Lucasmnascimento94/CS-341/ATMEGA-SCHEMATICS/SNAKE_GAME/SNAKE_GAME_PROGRAMMER_HARDWARE.drawio.pdf

Analog Switch
(CD4066BEU)

USB-UART
CONVERTER

USB_PORT

ATmega8
ISP

Analog Switch
(CD4066BEU)

FLOW_CONTROL

ATmega168
GRID_CONTROLLER

ATmega168
GAME_CONTROLLER

RESET_GRID_CONTROLLER

### SCK_BUS

MISO_BUS
MOSI_BUS

RESET_GAME_CONTROLLER

EXTERNAL FLASH

CHIP SELECT (CS)

External Programmer
Access

MISO_EXT

MOSI_EXT
SCK_EXT

RESET_PROGRAMMER

FLOW CONTROL
SWITCH (B)

LEVEL_SHIFTER

RXD_ISP

TXD_ISP
RTS_ISP

CTS_ISP

Analog Switch
(CD4066BEU)

RXD_ESP
TXD_ESP
CTS_ESP

FLOW CONTROL
SWITCH (B)

Analog Switch
(CD4066BEU)

RTS_ESP

RXD
TXD
RTS
CTS

FLOW_CONTROL

ESP

RXD
TXD

RTS
CTS

## PROGRAMMING LOGIC FLOW
