Lucasmnascimento94/CS-341/ATMEGA-SCHEMATICS/SNAKE_GAME/Clock_analyzes.xlsx

Sheet: Sheet1
Snake Game Clock Analyses
Atmega Clock Parameters |  |  | ws2812b Clock Parameters
Frequency |  | dcy (duty cycle) | Protocol Demand |  |  |  |  |  |  | GAME FPS
MHz | Hz |  | Data Feed |  |  |  |  |  |  | MIN_FPS
16 | 16000000 | 6.25e-08 | Kb/s | b/s | B/s | bit_cycle(us) | bi_cycle(s) | Latch(us) | Latch(s) | -
20 | 20000000 | 5e-08 | 800 | 800000 | 100000 | 1.25 | 1.25e-06 | 50 | 5e-05 | 14
Analyses
Row_Size | Column_Size | Pixel_Count | bit_per_grid | grid_cycle (CPU Time consumption) |  |  | max_FPS | fps_check
- | - | - | - | s | ms | us | -
16 | 8 | 128 | 3072 | 0.00389 | 3.89 | 3890 | 257.0694087 | OK
16 | 16 | 256 | 6144 | 0.00773 | 7.73 | 7730 | 129.3661061 | OK
24 | 16 | 384 | 9216 | 0.01157 | 11.57 | 11570 | 86.43042351 | OK
24 | 24 | 576 | 13824 | 0.01733 | 17.33 | 17330 | 57.7034045 | OK
32 | 24 | 768 | 18432 | 0.02309 | 23.09 | 23090 | 43.30879168 | OK
32 | 32 | 1024 | 24576 | 0.03077 | 30.77 | 30770 | 32.49918752 | OK
48 | 32 | 1536 | 36864 | 0.04613 | 46.13 | 46130 | 21.6778669 | OK
48 | 48 | 2304 | 55296 | 0.06917 | 69.17 | 69170 | 14.4571346 | OK
64 | 48 | 3072 | 73728 | 0.09221 | 92.21 | 92210 | 10.84481076 | FAIL
64 | 64 | 4096 | 98304 | 0.12293 | 122.93 | 122930 | 8.134710811 | FAIL
Project | Snake Game
Board | UMB-CS341-SNK-168-4848-F25-V1
Owner | Lucas Nascimento | Umass Boston - Computer Science
Rev | 1
Student_1 | -
Student_2 | -
Student_3 | -
Checked by: | Beatriz M Perez
Notes: | -

Sheet: BOM
Reference | Qty | Value | DNP | Exclude from BOM | Exclude from Board | Footprint | Datasheet
220UF1 | 1 | C_Polarized |  |  |  | Capacitor_THT:C_Disc_D3.0mm_W1.6mm_P2.50mm | ~
C1,C2,C3,C4,C5 | 5 | C_Small |  |  |  | Capacitor_THT:CP_Radial_D5.0mm_P2.50mm | ~
D1 | 1 | LED |  |  |  | LED_THT:LED_D1.8mm_W3.3mm_H2.4mm | ~
H1,H2,H3,H4,H5,H6,H7 | 7 | MountingHole |  | Excluded from BOM |  | MountingHole:MountingHole_3.2mm_M3 | ~
J1 | 1 | GRID |  |  |  | TerminalBlock:TerminalBlock_MaiXu_MX126-5.0-03P_1x03_P5.00mm | ~
J4 | 1 | USB_ASP |  |  |  | Connector_IDC:IDC-Header_2x05_P2.54mm_Vertical | ~
J5 | 1 | BUTTONS |  |  |  | TerminalBlock:TerminalBlock_MaiXu_MX126-5.0-03P_1x03_P5.00mm | ~
J6 | 1 | JOYSTICK |  |  |  | TerminalBlock:TerminalBlock_MaiXu_MX126-5.0-04P_1x04_P5.00mm | ~
J7 | 1 | UART_TERM |  |  |  | Connector_PinSocket_2.54mm:PinSocket_1x04_P2.54mm_Vertical | ~
J8 | 1 | PCF_SCREEN |  |  |  | TerminalBlock:TerminalBlock_MaiXu_MX126-5.0-04P_1x04_P5.00mm | ~
J9 | 1 | GROUND |  |  |  | TerminalBlock:TerminalBlock_MaiXu_MX126-5.0-04P_1x04_P5.00mm | ~
J10 | 1 | VCC |  |  |  | TerminalBlock:TerminalBlock_MaiXu_MX126-5.0-04P_1x04_P5.00mm | ~
J11 | 1 | PJ-102A |  |  |  | Connector_BarrelJack:BarrelJack_Horizontal | https://www.cui.com/product/resource/digikeypdf/pj-102a.pdf
R1,R2,R3,R4,R5,R6,R7,R13 | 8 | 100 |  |  |  | Resistor_THT:R_Axial_DIN0207_L6.3mm_D2.5mm_P10.16mm_Horizontal | ~
R14,R15,R16,R17,R18,R19,R20,R21,R22,R23,R24 | 11 | 4.7k |  |  |  | Resistor_THT:R_Axial_DIN0207_L6.3mm_D2.5mm_P10.16mm_Horizontal | ~
SW1 | 1 | SW_Push |  |  |  | Button_Switch_THT:SW_PUSH_6mm | ~
U1 | 1 | ATmega168A-P |  |  |  | Package_DIP:DIP-28_W7.62mm | http://ww1.microchip.com/downloads/en/DeviceDoc/ATmega48A_88A_168A-Data-Sheet-40002007A.pdf
Y1 | 1 | Crystal |  |  |  | Crystal:Resonator-2Pin_W6.0mm_H3.0mm | ~
