Lucasmnascimento94/CS-341/ATMEGA-SCHEMATICS/SNAKE_GAME/Clock_analyzes.ods

Sheet: Analyses
Snake Game Clock Analyses
Atmega Clock Parameters |  |  | ws2812b Clock Parameters
Frequency |  | dcy (duty cycle) | Protocol Demand |  |  |  |  |  |  | GAME FPS
MHz | Hz |  | Data Feed |  |  |  |  |  |  | MIN_FPS
16 | 16000000 | 0.0000000625 | Kb/s | b/s | B/s | bit_cycle(us) | bi_cycle(s) | Latch(us) | Latch(s) | -
20 | 20000000 | 0.00000005 | 800 | 800000 | 100000 | 1.25 | 0.00000125 | 50 | 0.00005 | 14
Analyses |  |  |  |  |  |  |  |  |  |  | 1228.8
Row_Size | Column_Size | Pixel_Count | bit_per_grid | grid_cycle (CPU Time consumption) |  |  | max_FPS | fps_check
- | - | - | - | s | ms | us | -
16 | 8 | 128 | 3072 | 0.00389 | 3.89 | 3890 | 257.06940874036 | OK
16 | 16 | 256 | 6144 | 0.00773 | 7.73 | 7730 | 129.366106080207 | OK
24 | 16 | 384 | 9216 | 0.01157 | 11.57 | 11570 | 86.4304235090752 | OK
24 | 24 | 576 | 13824 | 0.01733 | 17.33 | 17330 | 57.7034045008655 | OK
32 | 24 | 768 | 18432 | 0.02309 | 23.09 | 23090 | 43.308791684712 | OK
32 | 32 | 1024 | 24576 | 0.03077 | 30.77 | 30770 | 32.499187520312 | OK
48 | 32 | 1536 | 36864 | 0.04613 | 46.13 | 46130 | 21.6778668978972 | OK |  |  | 0.0000000625
48 | 48 | 2304 | 55296 | 0.06917 | 69.17 | 69170 | 14.4571345959231 | OK
64 | 48 | 3072 | 73728 | 0.09221 | 92.21 | 92210 | 10.8448107580523 | FAIL
64 | 64 | 4096 | 98304 | 0.12293 | 122.93 | 122930 | 8.13471081103067 | FAIL
Atmega Memory Parameters |  |  |  | Game Params
Flash |  | Ram |  | Grid_x | Grid_y | #Cells | Cell Size | Total Ram | Snake_Limit | Memory_Check
kbytes | bytes | kbytes | bytes | - |  |  | bytes | bytes
16 | 16000 | 2 | 2000 | 48 | 32 | 1536 | 9 | 13824 | 111.111111111111
 |  |  |  | 40 | 32 | 1280 |  | 11520
 |  |  |  | 32 | 32 | 1024 |  | 9216
 |  |  |  | 24 | 32 | 768 |  | 6912
 |  |  |  |  |  |  | 13824
Project | Snake Game
Board | UMB-CS341-SNK-168-4848-F25-V1
Owner | Lucas Nascimento | Umass Boston - Computer Science
Rev | 1
Student_1 | -
Student_2 | -
Student_3 | -
Checked by: | Beatriz M Perez
Notes: | -
 |  |  |  |  |  |  |  |  |  |  |  | _builtin_avr_delay_cycles(c)
 |  |  |  |  |  |  |  |  |  |  |  |  |  |  |  | 256
 |  |  |  |  |  |  |  |  |  |  |  |  | G | G | G | G | G | G | G | G | R | R | R | R | R | R | R | R | B | B | B | B | B | B | B | B
 |  |  |  |  |  |  |  |  |  |  |  |  | 1 | 2 | 3 | 4 | 5 | 6 | 7 | 8 | 9 | 10 | 11 | 12 | 13 | 14 | 15 | 16 | 17 | 18 | 19 | 20 | 21 | 22 | 23 | 24
 |  |  |  |  |  |  |  |  |  |  |  |  | 0 | 0 | 0 | 0 | 0 | 0 | 0 | 0 | 1 | 1 | 1 | 1 | 1 | 1 | 1 | 1 | 0 | 0 | 0 | 0 | 0 | 0 | 0 | 0

Sheet: GRID
 | EVEN LINE PATTERN – FULL ADDRESS EQUATION |  |  |  |  |  |  |  |  | ODD LINE PATTERN – FULL ADDRESS EQUATION
 | Address: |  | (J-1)*8 + I + (K-1)*256 |  |  |  |  |  |  | Address: |  | (J*8) + (1- I) + (K-1)*256
 | I: |  | I’ – (k-1)*8 |  |  |  |  |  |  | I: |  | I’ – (k-1)*8
ORIGINAL PIXEL ADDRESS TABLE |  |  | 48 | 47 | 46 | 45 | 44 | 43 | 42 | 41 | 40 | 39 | 38 | 37 | 36 | 35 | 34 | 33 | 32 | 31 | 30 | 29 | 28 | 27 | 26 | 25 | 24 | 23 | 22 | 21 | 20 | 19 | 18 | 17 | 16 | 15 | 14 | 13 | 12 | 11 | 10 | 9 | 8 | 7 | 6 | 5 | 4 | 3 | 2 | 1
 |  | 32 | 1288 | 1287 | 1286 | 1285 | 1284 | 1283 | 1282 | 1281 | 1280 | 1279 | 1278 | 1277 | 1276 | 1275 | 1274 | 1273 | 776 | 775 | 774 | 773 | 772 | 771 | 770 | 769 | 768 | 767 | 766 | 765 | 764 | 763 | 762 | 761 | 264 | 263 | 262 | 261 | 260 | 259 | 258 | 257 | 256 | 255 | 254 | 253 | 252 | 251 | 250 | 249 | 32 | 256 | 255 | 254 | 253 | 252 | 251 | 250
 |  | 31 | 1289 | 1290 | 1291 | 1292 | 1293 | 1294 | 1295 | 1296 | 1265 | 1266 | 1267 | 1268 | 1269 | 1270 | 1271 | 1272 | 777 | 778 | 779 | 780 | 781 | 782 | 783 | 784 | 753 | 754 | 755 | 756 | 757 | 758 | 759 | 760 | 265 | 266 | 267 | 268 | 269 | 270 | 271 | 272 | 241 | 242 | 243 | 244 | 245 | 246 | 247 | 248 | 31 | 241 | 242 | 243 | 244 | 245 | 246 | 247
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
 |  |  |  |  |  |  |  |  |  |  |  |  |  |  |  |  |  |  |  |  |  |  |  |  |  |  |  |  |  |  | 63
 |  |  |  |  |  |  |  |  |  |  |  |  |  |  |  |  |  |  |  |  |  |  |  |  |  |  |  |  | 0.000063

Sheet: BOM
Reference | Qty | Value | DNP | Exclude from BOM | Exclude from Board | Footprint | Datasheet
220UF1 | 1 | C_Polarized |  |  |  | Capacitor_THT:C_Disc_D3.0mm_W1.6mm_P2.50mm | ~
C1,C2,C3,C4,C5 | 5 | C_Small |  |  |  | Capacitor_THT:CP_Radial_D5.0mm_P2.50mm | ~
D1 | 1 | LED |  |  |  | LED_THT:LED_D1.8mm_W3.3mm_H2.4mm | ~
H1,H2,H3,H4,H5,H6,H7 | 7 | MountingHole |  | Excluded from BOM |  | MountingHole:MountingHole_3.2mm_M3 | ~
J1 | 1 | GRID |  |  |  | TerminalBlock:TerminalBlock_MaiXu_MX126-5.0-03P_1x03_P5.00mm | ~
J4 | 1 | USB_ASP |  |  |  | Connector_IDC:IDC-Header_2x05_P2.54mm_Vertical | ~
J5 | 1 | BUTTONS |  |  |  | TerminalBlock:TerminalBlock_MaiXu_MX126-5.0-03P_1x03_P5.00mm | ~
J6 | 1 | JOYSTICK |  |  |  | TerminalBlock:TerminalBlock_MaiXu_MX126-5.0-04P_1x04_P5.00mm | ~
J7 | 1 | UART_TERM |  |  |  | Connector_PinSocket_2.54mm:PinSocket_1x04_P2.54mm_Vertical | ~
J8 | 1 | PCF_SCREEN |  |  |  | TerminalBlock:TerminalBlock_MaiXu_MX126-5.0-04P_1x04_P5.00mm | ~
J9 | 1 | GROUND |  |  |  | TerminalBlock:TerminalBlock_MaiXu_MX126-5.0-04P_1x04_P5.00mm | ~
J10 | 1 | VCC |  |  |  | TerminalBlock:TerminalBlock_MaiXu_MX126-5.0-04P_1x04_P5.00mm | ~
J11 | 1 | PJ-102A |  |  |  | Connector_BarrelJack:BarrelJack_Horizontal | https://www.cui.com/product/resource/digikeypdf/pj-102a.pdf
R1,R2,R3,R4,R5,R6,R7,R13 | 8 | 100 |  |  |  | Resistor_THT:R_Axial_DIN0207_L6.3mm_D2.5mm_P10.16mm_Horizontal | ~
R14,R15,R16,R17,R18,R19,R20,R21,R22,R23,R24 | 11 | 4.7k |  |  |  | Resistor_THT:R_Axial_DIN0207_L6.3mm_D2.5mm_P10.16mm_Horizontal | ~
SW1 | 1 | SW_Push |  |  |  | Button_Switch_THT:SW_PUSH_6mm | ~
U1 | 1 | ATmega168A-P |  |  |  | Package_DIP:DIP-28_W7.62mm | http://ww1.microchip.com/downloads/en/DeviceDoc/ATmega48A_88A_168A-Data-Sheet-40002007A.pdf
Y1 | 1 | Crystal |  |  |  | Crystal:Resonator-2Pin_W6.0mm_H3.0mm | ~
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
