Lucasmnascimento94/CS-341/ATMEGA-SCHEMATICS/SNAKE_GAME/isp_tests/isp_decoder/blinky.csv

Time [s] | Packet ID | MOSI | MISO
6.8434262500 | 0 | 0xAC | 0xE9
6.8444904000 | 0 | 0x53 | 0x72
6.8456048500 | 0 | 0x00 | 0x53
6.8466717000 | 0 | 0x00 | 0x00
6.8583836500 | 0 | 0x30 | 0x00
6.8594399000 | 0 | 0x00 | 0x30
6.8605444000 | 0 | 0x00 | 0x00
6.8616072500 | 0 | 0x00 | 0x1E
6.8633885000 | 0 | 0x30 | 0x00
6.8644372500 | 0 | 0x00 | 0x30
6.8654988500 | 0 | 0x01 | 0x00
6.8665444500 | 0 | 0x00 | 0x94
6.8682129000 | 0 | 0x30 | 0x00
6.8692429000 | 0 | 0x00 | 0x30
6.8703470000 | 0 | 0x02 | 0x00
6.8713763500 | 0 | 0x00 | 0x06
6.8736581000 | 0 | 0xAC | 0x00
6.8747365500 | 0 | 0x80 | 0xAC
6.8757977000 | 0 | 0x00 | 0x80
6.8768643000 | 0 | 0x00 | 0x00
6.9899111500 | 0 | 0xAC | 0xB6
6.9909932500 | 0 | 0x53 | 0x8C
6.9921131000 | 0 | 0x00 | 0x53
6.9931586500 | 0 | 0x00 | 0x00
6.9964043500 | 0 | 0x20 | 0x00
6.9974839500 | 0 | 0x00 | 0x20
6.9985242000 | 0 | 0x40 | 0x00
6.9996070000 | 0 | 0x00 | 0xFF
7.0006941000 | 0 | 0x28 | 0x00
7.0018040000 | 0 | 0x00 | 0x28
7.0028710000 | 0 | 0x40 | 0x00
7.0039271000 | 0 | 0x00 | 0xFF
7.0050087000 | 0 | 0x20 | 0x00
7.0061000500 | 0 | 0x00 | 0x20
7.0071697000 | 0 | 0x41 | 0x00
7.0082363000 | 0 | 0x00 | 0xFF
7.0093585000 | 0 | 0x28 | 0x00
7.0104333500 | 0 | 0x00 | 0x28
7.0115377500 | 0 | 0x41 | 0x00
7.0126098500 | 0 | 0x00 | 0xFF
7.0136913500 | 0 | 0x20 | 0x00
7.0147960500 | 0 | 0x00 | 0x20
7.0158736500 | 0 | 0x42 | 0x00
7.0169734000 | 0 | 0x00 | 0xFF
7.0180570000 | 0 | 0x28 | 0x00
7.0191669000 | 0 | 0x00 | 0x28
7.0201992500 | 0 | 0x42 | 0x00
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
10.4090582000 | 0 | 0x7C | 0x00
10.4101197500 | 0 | 0x00 | 0xFF
10.4112150000 | 0 | 0x28 | 0x00
10.4123061500 | 0 | 0x00 | 0x28
10.4133679500 | 0 | 0x7C | 0x00
10.4144292000 | 0 | 0x00 | 0xFF
10.4155163000 | 0 | 0x20 | 0x00
10.4166376500 | 0 | 0x00 | 0x20
10.4176612000 | 0 | 0x7D | 0x00
10.4186905000 | 0 | 0x00 | 0xFF
10.4197298500 | 0 | 0x28 | 0x00
10.4207996000 | 0 | 0x00 | 0x28
10.4218317500 | 0 | 0x7D | 0x00
10.4229227500 | 0 | 0x00 | 0xFF
10.4239643000 | 0 | 0x20 | 0x00
10.4249941500 | 0 | 0x00 | 0x20
10.4260187000 | 0 | 0x7E | 0x00
10.4270425500 | 0 | 0x00 | 0xFF
10.4280925500 | 0 | 0x28 | 0x00
10.4291435000 | 0 | 0x00 | 0x28
10.4302478500 | 0 | 0x7E | 0x00
10.4312772500 | 0 | 0x00 | 0xFF
10.4323433000 | 0 | 0x20 | 0x00
10.4334103500 | 0 | 0x00 | 0x20
10.4344559500 | 0 | 0x7F | 0x00
10.4355015500 | 0 | 0x00 | 0xFF
10.4365779000 | 0 | 0x28 | 0x00
10.4376290000 | 0 | 0x00 | 0x28
10.4386905000 | 0 | 0x7F | 0x00
10.4397522500 | 0 | 0x00 | 0xFF
