Lucasmnascimento94/CS-341/ATMEGA-SCHEMATICS/SNAKE_GAME/isp_tests/isp_decoder/powertest_5vsupply.csv

Time [s] | Packet ID | MOSI | MISO
1.0328180000 | 0 | 0xAC | 0x00
1.0329436400 | 0 | 0x53 | 0x00
1.0330693200 | 0 | 0x00 | 0x53
1.0331952400 | 0 | 0x00 | 0x00
1.0333222800 | 0 | 0xAC | 0x00
1.0334481600 | 0 | 0x80 | 0xAC
1.0335740400 | 0 | 0x00 | 0x80
1.0336998000 | 0 | 0x00 | 0x00
1.1400418000 | 1 | 0xAC | 0x00
1.1401674000 | 1 | 0x53 | 0x00
1.1402930400 | 1 | 0x00 | 0x53
1.1404189600 | 1 | 0x00 | 0x00
1.1405474800 | 1 | 0x40 | 0x00
1.1406733200 | 1 | 0x00 | 0x40
1.1407990800 | 1 | 0x00 | 0x00
1.1409253200 | 1 | 0x0C | 0x00
1.1410528800 | 1 | 0x48 | 0x0C
1.1411787200 | 1 | 0x00 | 0x48
1.1413045600 | 1 | 0x00 | 0x00
1.1414307600 | 1 | 0x94 | 0x00
1.1415589200 | 1 | 0x40 | 0x94
1.1416847200 | 1 | 0x00 | 0x40
1.1418106000 | 1 | 0x01 | 0x00
1.1419368800 | 1 | 0x34 | 0x01
1.1420646800 | 1 | 0x48 | 0x34
1.1421904400 | 1 | 0x00 | 0x48
1.1423163200 | 1 | 0x01 | 0x00
1.1424426000 | 1 | 0x00 | 0x01
1.1425708400 | 1 | 0x40 | 0x00
1.1426966000 | 1 | 0x00 | 0x40
1.1428222800 | 1 | 0x02 | 0x00
1.1429483600 | 1 | 0x0C | 0x02
1.1430760400 | 1 | 0x48 | 0x0C
1.1432018800 | 1 | 0x00 | 0x48
1.1433278000 | 1 | 0x02 | 0x00
1.1434540400 | 1 | 0x94 | 0x02
1.1435823600 | 1 | 0x40 | 0x94
1.1437082000 | 1 | 0x00 | 0x40
1.1438340000 | 1 | 0x03 | 0x00
1.1439602400 | 1 | 0x3E | 0x03
1.1440881200 | 1 | 0x48 | 0x3E
1.1442139600 | 1 | 0x00 | 0x48
1.1443397600 | 1 | 0x03 | 0x00
1.1444659600 | 1 | 0x00 | 0x03
1.1445942000 | 1 | 0x40 | 0x00
1.1447200800 | 1 | 0x00 | 0x40
1.1448458800 | 1 | 0x04 | 0x00
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
1.4039858000 | 1 | 0x00 | 0xFF
1.4041134800 | 1 | 0x20 | 0x00
1.4042390800 | 1 | 0x00 | 0x20
1.4043647600 | 1 | 0x7F | 0x00
1.4044909200 | 1 | 0x00 | 0xFF
1.4046179600 | 1 | 0x28 | 0x00
1.4047437200 | 1 | 0x00 | 0x28
1.4048695200 | 1 | 0x7F | 0x00
1.4049956800 | 1 | 0x00 | 0xFF
