Lucasmnascimento94/CS-341/ATMEGA-SCHEMATICS/SNAKE_GAME/isp_tests/isp_decoder/powertest_breadboard.csv

Time [s] | Packet ID | MOSI | MISO
1.3650373600 | 0 | 0xAC | 0x8C
1.3651629600 | 0 | 0x53 | 0x25
1.3652885600 | 0 | 0x00 | 0x53
1.3654142400 | 0 | 0x00 | 0x00
1.3655411200 | 0 | 0xAC | 0x00
1.3656669600 | 0 | 0x80 | 0xAC
1.3657928400 | 0 | 0x00 | 0x80
1.3659184800 | 0 | 0x00 | 0x00
1.4722734800 | 1 | 0xAC | 0x05
1.4723990400 | 1 | 0x53 | 0x30
1.4725246800 | 1 | 0x00 | 0x53
1.4726504800 | 1 | 0x00 | 0x00
1.4727789600 | 1 | 0x40 | 0x00
1.4729047200 | 1 | 0x00 | 0x40
1.4730304400 | 1 | 0x00 | 0x00
1.4731564800 | 1 | 0x0C | 0x00
1.4732840800 | 1 | 0x48 | 0x0C
1.4734097600 | 1 | 0x00 | 0x48
1.4735354400 | 1 | 0x00 | 0x00
1.4736614800 | 1 | 0x94 | 0x00
1.4737895200 | 1 | 0x40 | 0x94
1.4739151600 | 1 | 0x00 | 0x40
1.4740408400 | 1 | 0x01 | 0x00
1.4741669200 | 1 | 0x34 | 0x01
1.4742944400 | 1 | 0x48 | 0x34
1.4744200800 | 1 | 0x00 | 0x48
1.4745457600 | 1 | 0x01 | 0x00
1.4746717600 | 1 | 0x00 | 0x01
1.4748000000 | 1 | 0x40 | 0x00
1.4749256400 | 1 | 0x00 | 0x40
1.4750513200 | 1 | 0x02 | 0x00
1.4751774400 | 1 | 0x0C | 0x02
1.4753050400 | 1 | 0x48 | 0x0C
1.4754307200 | 1 | 0x00 | 0x48
1.4755564400 | 1 | 0x02 | 0x00
1.4756824800 | 1 | 0x94 | 0x02
1.4758105600 | 1 | 0x40 | 0x94
1.4759362400 | 1 | 0x00 | 0x40
1.4760618800 | 1 | 0x03 | 0x00
1.4761880000 | 1 | 0x3E | 0x03
1.4763156000 | 1 | 0x48 | 0x3E
1.4764412800 | 1 | 0x00 | 0x48
1.4765669600 | 1 | 0x03 | 0x00
1.4766929600 | 1 | 0x00 | 0x03
1.4768210800 | 1 | 0x40 | 0x00
1.4769468000 | 1 | 0x00 | 0x40
1.4770725600 | 1 | 0x04 | 0x00
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
1.7364102800 | 1 | 0x00 | 0xFF
1.7365379200 | 1 | 0x20 | 0x00
1.7366637200 | 1 | 0x00 | 0x20
1.7367894400 | 1 | 0x7F | 0x00
1.7369156400 | 1 | 0x00 | 0xFF
1.7370427200 | 1 | 0x28 | 0x00
1.7371684800 | 1 | 0x00 | 0x28
1.7372942800 | 1 | 0x7F | 0x00
1.7374204800 | 1 | 0x00 | 0xFF
