Lucasmnascimento94/CS-341/ATMEGA-SCHEMATICS/SNAKE_GAME/isp_tests/isp_decoder/write_blinky.csv

Time [s] | Packet ID | MOSI | MISO
7.4616617000 | 0 | 0xAC | 0xD9
7.4626772000 | 0 | 0x53 | 0x24
7.4636928500 | 0 | 0x00 | 0x53
7.4647065500 | 0 | 0x00 | 0x00
7.4657485500 | 1 | 0xAC | 0x8E
7.4667641500 | 1 | 0x80 | 0xBF
7.4677806000 | 1 | 0x00 | 0x38
7.4687954500 | 1 | 0x00 | 0x7B
7.4795652000 | 2 | 0xAC | 0xA9
7.4805804000 | 2 | 0x53 | 0xA8
7.4815959500 | 2 | 0x00 | 0x53
7.4826092500 | 2 | 0x00 | 0x00
7.4836480500 | 3 | 0x40 | 0xB3
7.4846626500 | 3 | 0x00 | 0xE5
7.4856788500 | 3 | 0x00 | 0x95
7.4866934000 | 3 | 0x0C | 0x48
7.4877354000 | 4 | 0x48 | 0x90
7.4887500000 | 4 | 0x00 | 0x2E
7.4897657000 | 4 | 0x00 | 0x58
7.4907821000 | 4 | 0x94 | 0xE0
7.4918298000 | 5 | 0x40 | 0xDB
7.4928454500 | 5 | 0x00 | 0x0D
7.4938616500 | 5 | 0x01 | 0xDE
7.4948779500 | 5 | 0x34 | 0xE3
7.4959216500 | 6 | 0x48 | 0xF8
7.4969378000 | 6 | 0x00 | 0x3E
7.4979536500 | 6 | 0x01 | 0x1E
7.4989699000 | 6 | 0x00 | 0x56
7.5000169000 | 7 | 0x40 | 0x90
7.5010328000 | 7 | 0x00 | 0x1A
7.5020483500 | 7 | 0x02 | 0x37
7.5030640500 | 7 | 0x0C | 0x64
7.5041070000 | 8 | 0x48 | 0x9E
7.5051220500 | 8 | 0x00 | 0x55
7.5061376000 | 8 | 0x02 | 0x53
7.5071540000 | 8 | 0x94 | 0xBA
7.5082015500 | 9 | 0x40 | 0xC1
7.5092170500 | 9 | 0x00 | 0xAC
7.5102321500 | 9 | 0x03 | 0x99
7.5112471500 | 9 | 0x3E | 0xD8
7.5122904000 | 10 | 0x48 | 0x31
7.5133057500 | 10 | 0x00 | 0x7F
7.5143214000 | 10 | 0x03 | 0x18
7.5153365000 | 10 | 0x00 | 0x9F
7.5163834000 | 11 | 0x40 | 0xF7
7.5173986500 | 11 | 0x00 | 0x1D
7.5184144000 | 11 | 0x04 | 0x3B
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
8.5348249500 | 258 | 0xFF | 0x5F
8.5358649000 | 259 | 0x48 | 0x4D
8.5368786000 | 259 | 0x00 | 0x16
8.5378931000 | 259 | 0x7F | 0x69
8.5389070000 | 259 | 0xFF | 0x17
8.5399600500 | 260 | 0x4C | 0xCD
8.5409750000 | 260 | 0x00 | 0x2E
8.5419903500 | 260 | 0x7F | 0x0A
8.5430063000 | 260 | 0x00 | 0xFD
