Lucasmnascimento94/CS-341/(threads)

Thread 23 (2025-09-24):

HW-POWER_MANAGEMENT

Lucasmnascimento94, 2025-09-24:
**POWER MANAGEMENT AS IT IS**

This task is responsible for handling one of the biggest issues on driving LEDs. The current design can't handle all the LEDs ON at the same time, at least for sure not with white color, which required to turn ON R-G-B in full brightness. As it is right now, the GRID is drawing around 600mA with 50 Pixels on at the same time with RED color, therefore we need to figure out a power management to handle this difficiency, otherwise there is a risk of the game shutting down due to overheating in the voltage regulator.

**PLAN FOR FUTURE DESIGN**
LED Power Plan — Zoned 3.3 V LDO
Summary
We’re powering the LED grid at 3.3 V to cut current and heat. Brightness is lower but acceptable for this project, and color looks fine. To avoid current-sharing issues, the grid is split into isolated power zones, each fed by its own 3.3 V LDO and capacitors. Zones share ground only; +3V3 rails are not tied together. Therefore, instead of trying to supply current to all the grid out of one source, we will split it in zones to facilitate it.

Rationale
- The previous 5 V path risks overheating at worst-case full-white.
- The current 3V3 Measured ~600 mA with ~50 pixels at solid red; full-white scales higher.
> Therefore either a big buck

Thread 35 (2025-09-24):

<SWE-EXT-FLASH> Validation

Lucasmnascimento94, 2025-09-24:
- Functional: JEDEC ID OK; read/verify assets; SRAM round-trip tests (patterns).
- System: level load → render → no flicker. Asset streaming does not violate LED timing.
- Throughput: measure flash→SRAM copy of a level-sized chunk; confirm it fits within a “loading screen” budget.

Thread 37 (2025-09-25):

<SWE> PROGRAMMER

Lucasmnascimento94, 2025-09-25:
***On-Board Programmer (ATmega8)***

Goal: Remove the dependency on external USBASP programmers by integrating a dedicated ATmega8 that can program all MCUs on the console via ISP/UART, selected by software.

***Why***
- Self-contained product: flash, update, and test.
- Manufacturing & field updates: one USB connection for everything.
- Learning value: real bus arbitration, memory maps, and multi-target update flows.

***What it does***
- Acts as a programmable bridge between USB-UART and the target AVR(s).
- Selects the target MCU (grid/logic/etc.) via commands, then enters a programming session.
- Speaks a doc-driven protocol (e.g., AVR910 or STK500 subset) implemented in plain avr-libc (no Arduino).

***Hardware snapshot***
- MCU: ATmega8 (TQFP-32)
- I/O: Shared MISO/MOSI/SCK to all targets, per-target RESET lines
- PC link: USB-UART (e.g., CP2102/FT232)

***Control & workflow***
- Host opens the COM port and sends a short preamble (e.g., target=grid proto=avr910 sck=med).
- Programmer asserts the chosen target’s RESET, isolates others, and arms the bus.

Thread 38 (2025-09-25):

<HW> PROGRAMMER

Lucasmnascimento94, 2025-09-25:
***Overview***
We integrate a dedicated ATmega8/ATmega88PA as an on-board programmer to flash all target MCUs on the console. The programmer exposes a single USB-UART to the host and arbitrates access to the ISP (SPI + RESET) lines of each target. This removes the need for external USBASP dongles and supports manufacturing/field updates from one cable.

***Topology (ISP-first, UART)***
- ISP bus (primary): Shared MOSI/SCK to all targets; per-target RESET; MISO isolated per target (held in reset or via mux).
- Optional UART boot path: Dual-SPDT switch to route TX/RX to one selected target (for serial bootloaders).
- Host link: USB-UART bridge (FT232/CH340CP2102/CH340).

Thread 39 (2025-09-25):

<HW-PROG> Power

Lucasmnascimento94, 2025-09-25:
- Decide ISP-first (shared MOSI/SCK, per-target RESET), optional MISO mux (so non-targets can keep running).

- Vcc plan: 3.3 V preferred; add level shifters if any target is 5 V.

- Acceptance: Block diagram + pin map + bus ownership truth table checked in.
