Lucasmnascimento94/CS-341/ATMEGA-SCHEMATICS/SNAKE_GAME/LASER/SNAKE_GAME-B_Cu.pdf

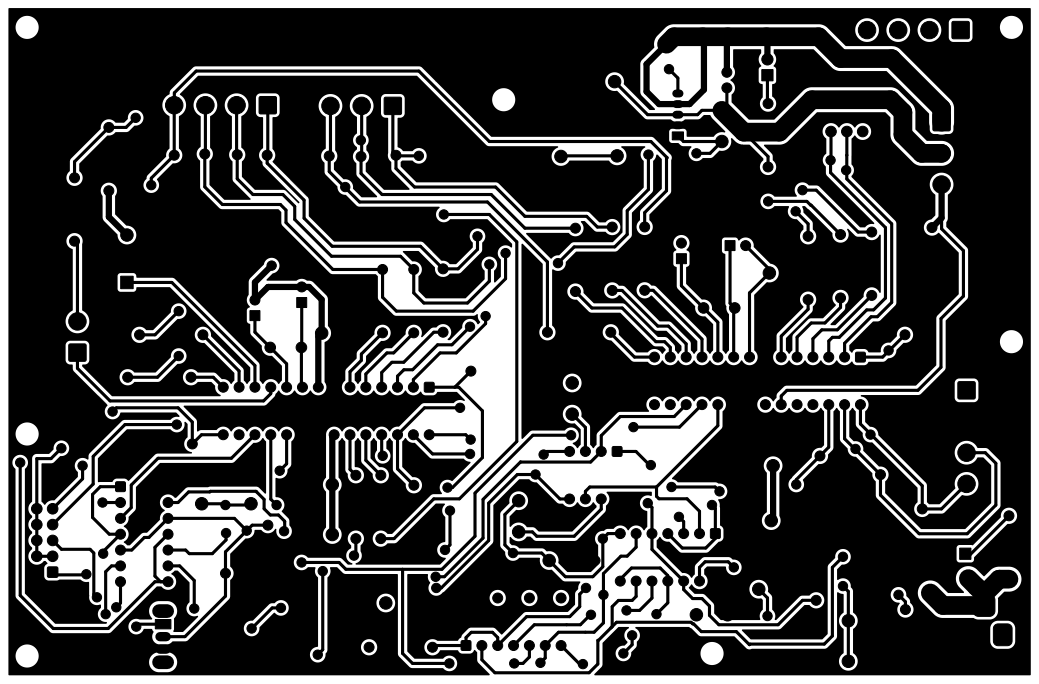
[picture p1: page 1]
