Lucasmnascimento94/CS-341/ATMEGA-SCHEMATICS/SNAKE_GAME/LASER/SNAKE_GAME-B_Mask.pdf

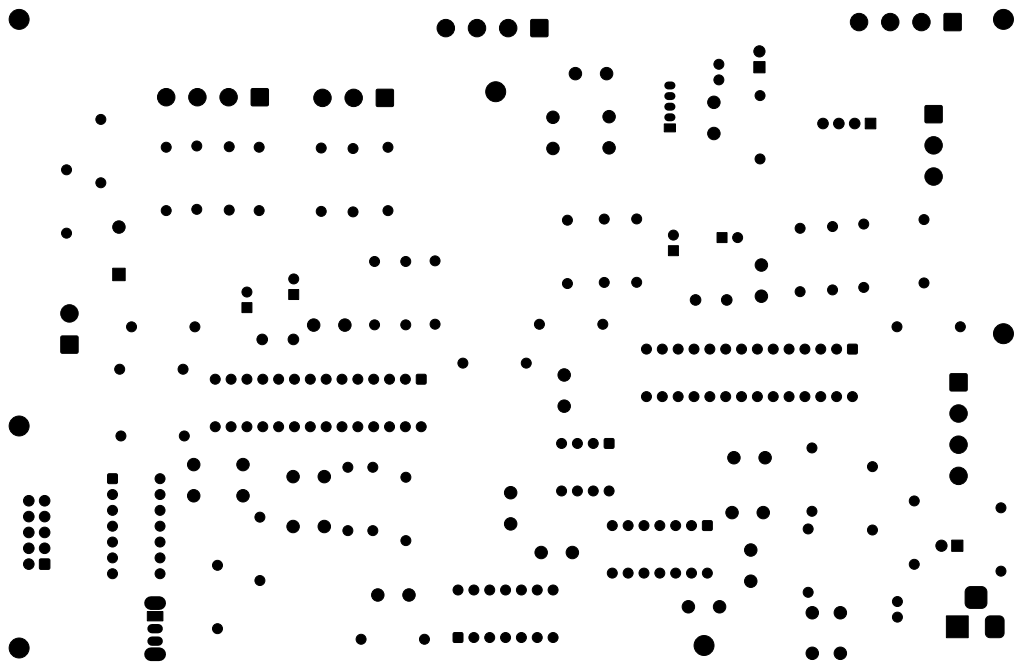
[picture p2: page 1]
