Lucasmnascimento94/CS-341/ATMEGA-SCHEMATICS/SNAKE_GAME/LASER/SNAKE_GAME-F_Cu.pdf

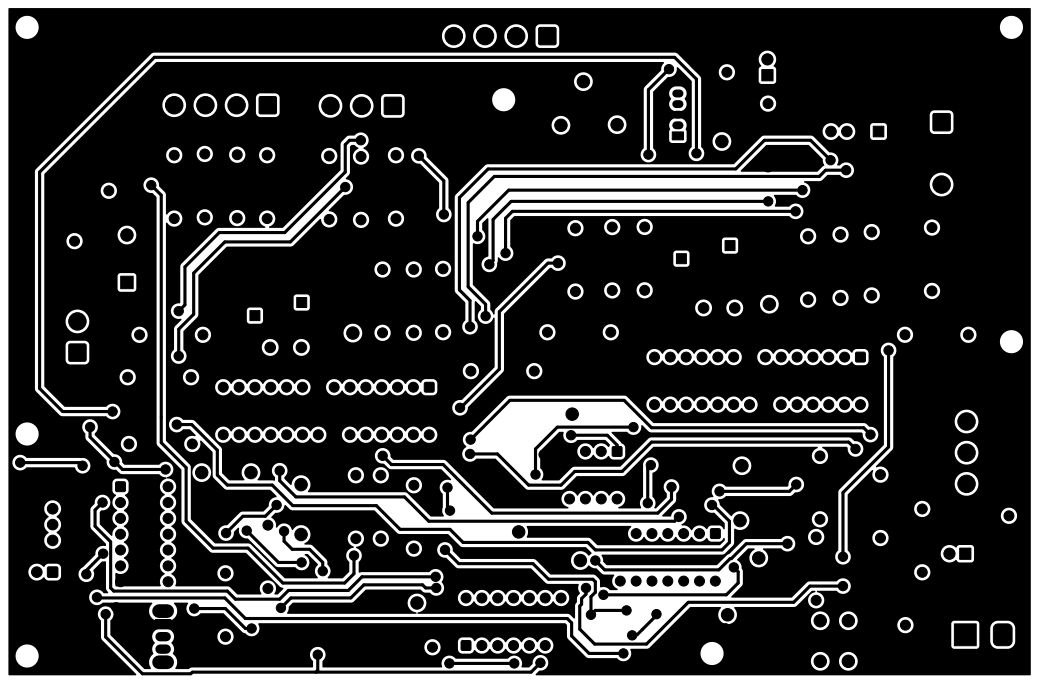
[picture p3: page 1]
