Lucasmnascimento94/CS-341/ATMEGA-SCHEMATICS/SNAKE_GAME/LASER/SNAKE_GAME-F_Silkscreen.pdf

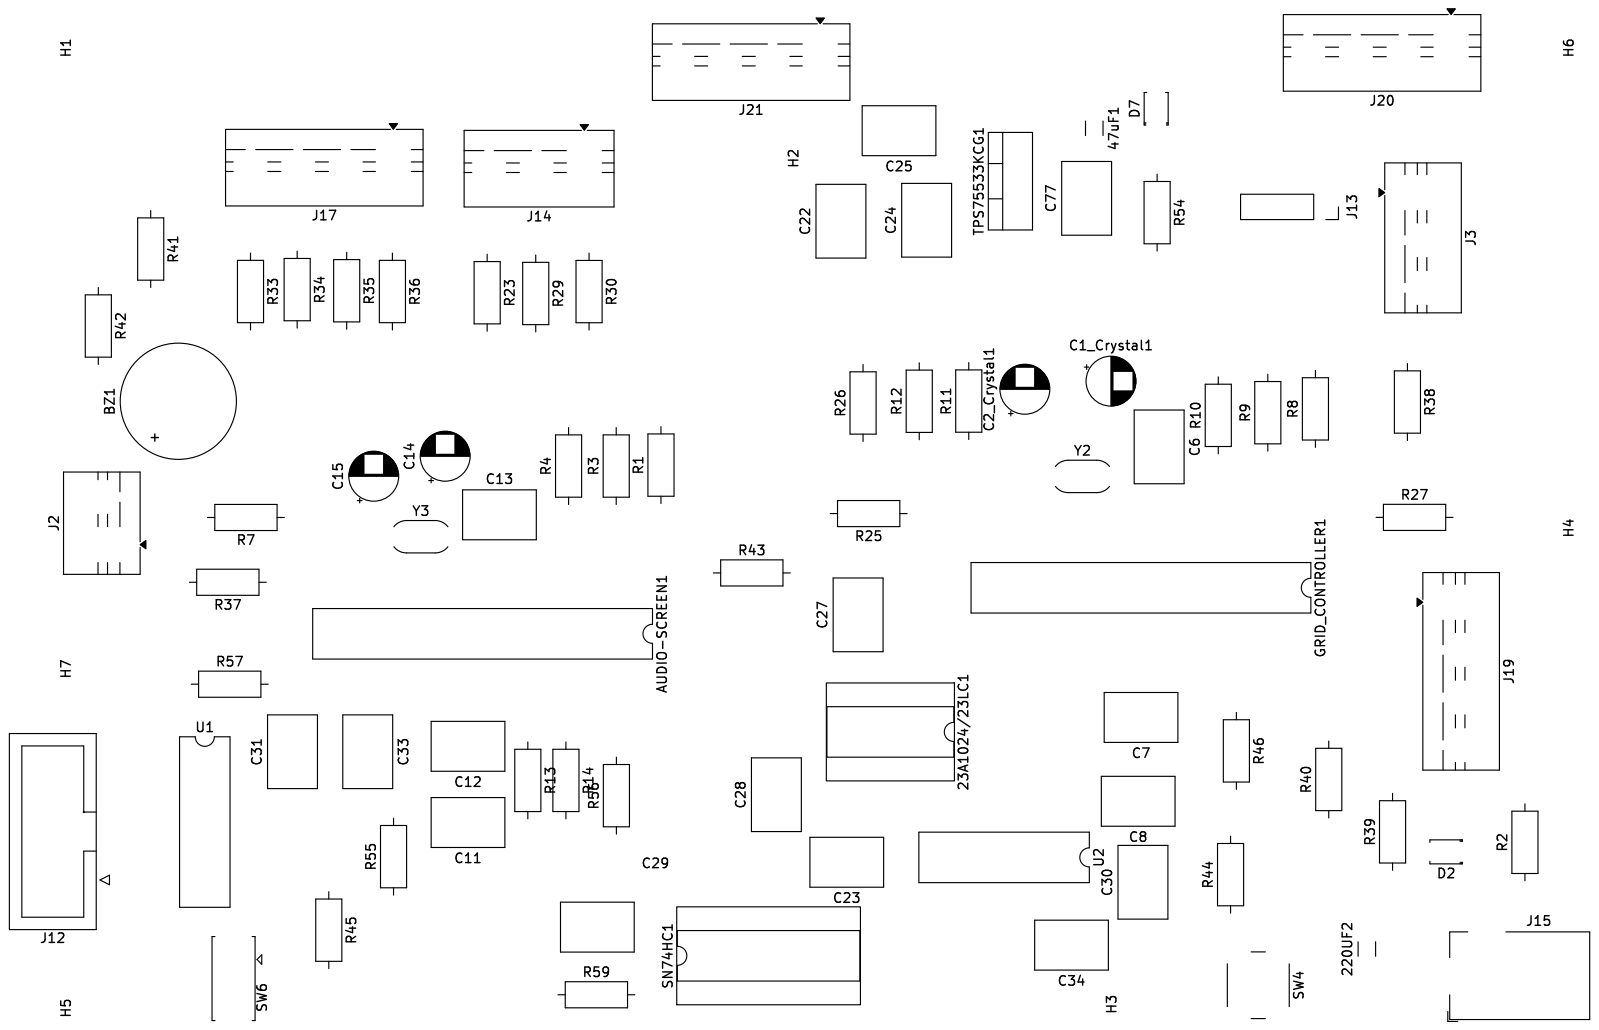
[picture p4: page 1]
