Lucasmnascimento94/CS-341/ATMEGA-SCHEMATICS/SNAKE_GAME/SNAKE_GAME.kicad_pcb

## KiCad design ATMEGA-SCHEMATICS/SNAKE_GAME/SNAKE_GAME.kicad_pcb (2025-10-01)

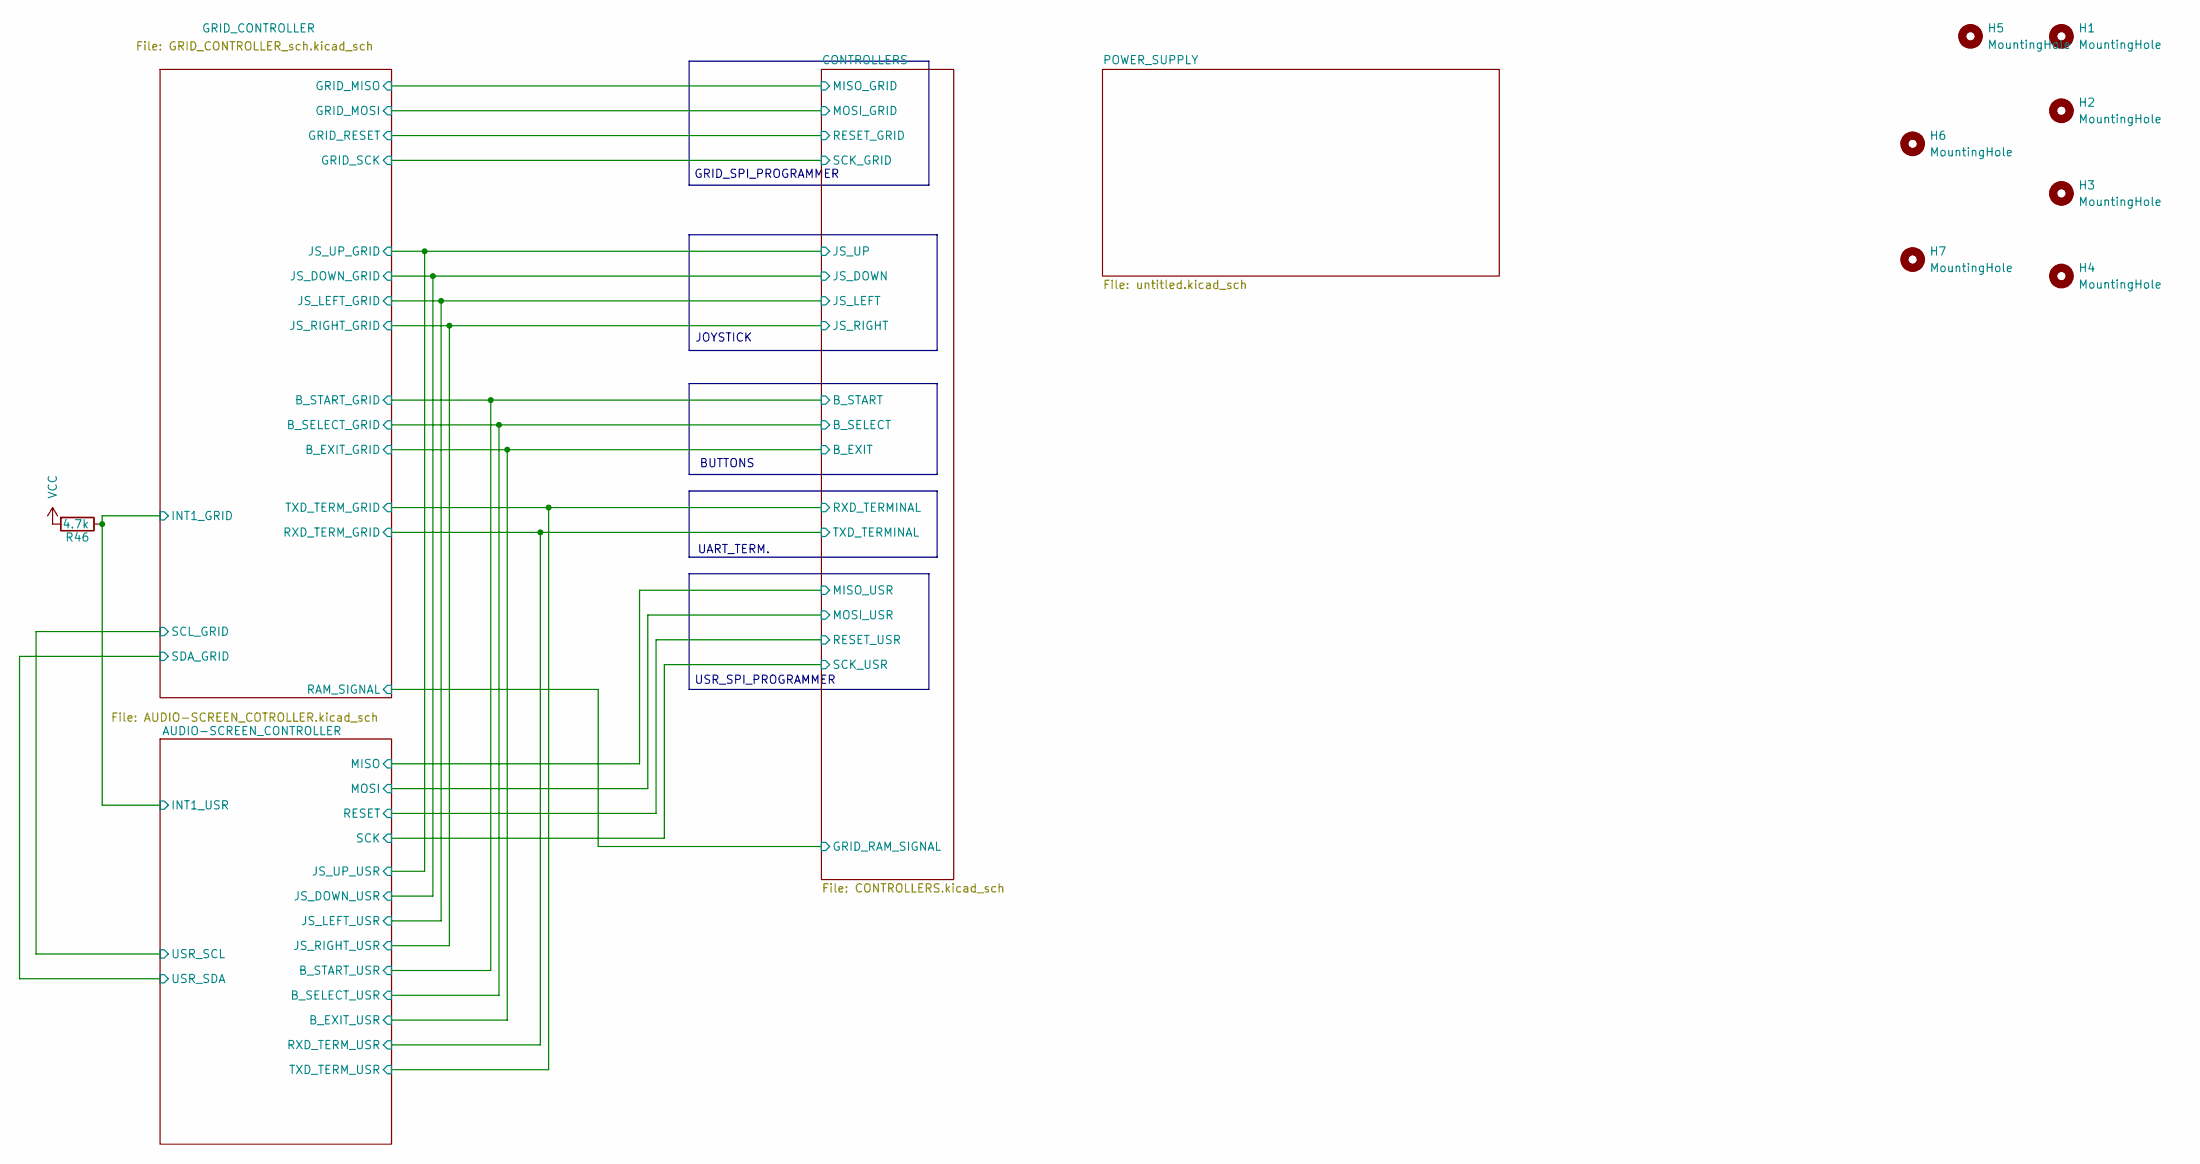
[picture p5: schematic SNAKE_GAME.kicad_sch]

Parts:
H1, H2, H3, H4, H5, H6, H7: MountingHole; MountingHole_3.2mm_M3
R46: 4.7k; R_Axial_DIN0207_L6.3mm_D2.5mm_P10.16mm_Horizontal

Connections:
/AUDIO-SCREEN_CONTROLLER/INT1_USR: R46.1; also elsewhere on the board
VCC: R46.2; also elsewhere on the board

Notes on the sheet:
BUTTONS
JOYSTICK
USR_SPI_PROGRAMMER
UART_TERM.
GRID_SPI_PROGRAMMER

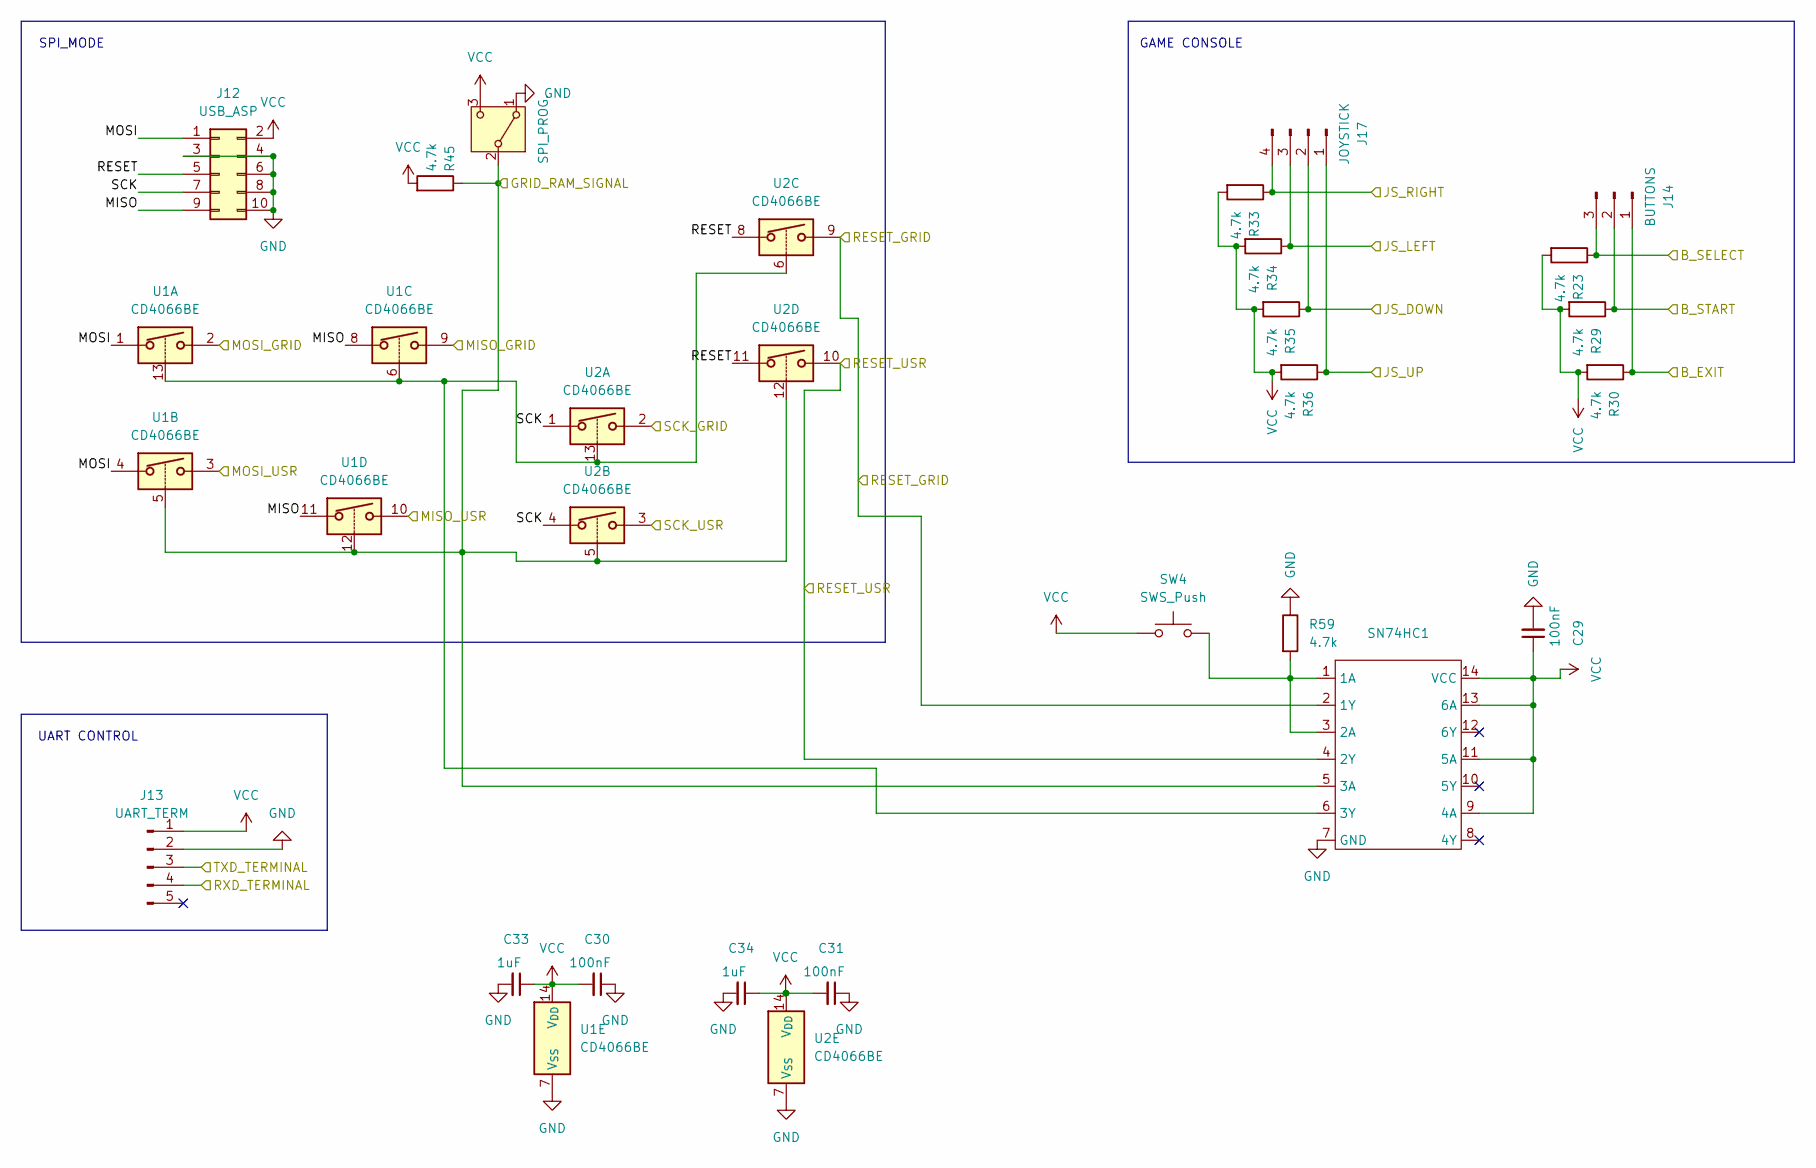
[picture p6: schematic CONTROLLERS.kicad_sch]

Parts:
C29, C30, C31: 100nF; C_Disc_D7.5mm_W5.0mm_P5.00mm
C33, C34: 1uF; C_Disc_D7.5mm_W5.0mm_P5.00mm
J12: USB_ASP; IDC-Header_2x05_P2.54mm_Vertical
J13: UART_TERM; PinSocket_1x04_P2.54mm_Vertical
J14: BUTTONS; TerminalBlock_MaiXu_MX126-5.0-03P_1x03_P5.00mm
J17: JOYSTICK; TerminalBlock_MaiXu_MX126-5.0-04P_1x04_P5.00mm
R23, R29, R30, R33, R34, R35, R36, R45, R59: 4.7k; R_Axial_DIN0207_L6.3mm_D2.5mm_P10.16mm_Horizontal
SN74HC1: CERDIP-14_W7.62mm_SideBrazed_Socket
SW4: SWS_Push; SW_PUSH_6mm
SW6: SPI_PROG.; SW_Slide_SPDT_Straight_CK_OS102011MS2Q
U1, U2: CD4066BE; DIP-14_W7.62mm

Connections:
/AUDIO-SCREEN_CONTROLLER/B_EXIT_USR: J14.1, R30.1; also elsewhere on the board
/AUDIO-SCREEN_CONTROLLER/B_SELECT_USR: J14.3, R23.1; also elsewhere on the board
/AUDIO-SCREEN_CONTROLLER/B_START_USR: J14.2, R29.1; also elsewhere on the board
/AUDIO-SCREEN_CONTROLLER/JS_DOWN_USR: J17.2, R35.1; also elsewhere on the board
/AUDIO-SCREEN_CONTROLLER/JS_LEFT_USR: J17.3, R34.1; also elsewhere on the board
/AUDIO-SCREEN_CONTROLLER/JS_RIGHT_USR: J17.4, R33.1; also elsewhere on the board
/AUDIO-SCREEN_CONTROLLER/JS_UP_USR: J17.1, R36.1; also elsewhere on the board
/AUDIO-SCREEN_CONTROLLER/MISO: U1.10; also elsewhere on the board
/AUDIO-SCREEN_CONTROLLER/MOSI: U1.3; also elsewhere on the board
/AUDIO-SCREEN_CONTROLLER/RESET: SN74HC1.4 (2Y), U2.10; also elsewhere on the board
/AUDIO-SCREEN_CONTROLLER/RXD_TERM_USR: J13.3; also elsewhere on the board
/AUDIO-SCREEN_CONTROLLER/SCK: U2.3; also elsewhere on the board
/AUDIO-SCREEN_CONTROLLER/TXD_TERM_USR: J13.4; also elsewhere on the board
/CONTROLLERS/GRID_RAM_SIGNAL: R45.1, SN74HC1.5 (3A), SW6.2 (B), U1.5, U1.12, U2.5, U2.12; also elsewhere on the board
/CONTROLLERS/MISO: J12.9, U1.8, U1.11
/CONTROLLERS/MISO_GRID: U1.9; also elsewhere on the board
/CONTROLLERS/MOSI: J12.1, U1.1, U1.4
/CONTROLLERS/MOSI_GRID: U1.2; also elsewhere on the board
/CONTROLLERS/RESET: J12.5, U2.8, U2.11
/CONTROLLERS/RESET_GRID: SN74HC1.2 (1Y), U2.9; also elsewhere on the board
/CONTROLLERS/SCK: J12.7, U2.1, U2.4
/CONTROLLERS/SCK_GRID: U2.2; also elsewhere on the board
GND: C29.2, C30.1, C31.1, C33.2, C34.2, J12.3, J12.4, J12.6, J12.8, J12.10, J13.2, R59.1, SN74HC1.7 (GND), SW6.1 (A), U1.7 (V_{SS}), U2.7 (V_{SS}); also elsewhere on the board
unnamed: R59.2, SN74HC1.1 (1A), SN74HC1.3 (2A), SW4.1
unnamed: SN74HC1.6 (3Y), U1.6, U1.13, U2.6, U2.13
VCC: C29.1, C30.2, C31.2, C33.1, C34.1, J12.2, J13.1, R23.2, R29.2, R30.2, R33.2, R34.2, R35.2, R36.2, R45.2, SN74HC1.9 (4A), SN74HC1.11 (5A), SN74HC1.13 (6A), SN74HC1.14 (VCC), SW4.2, SW6.3 (C), U1.14 (V_{DD}), U2.14 (V_{DD}); also elsewhere on the board

Notes on the sheet:
UART CONTROL
GAME CONSOLE
SPI_MODE

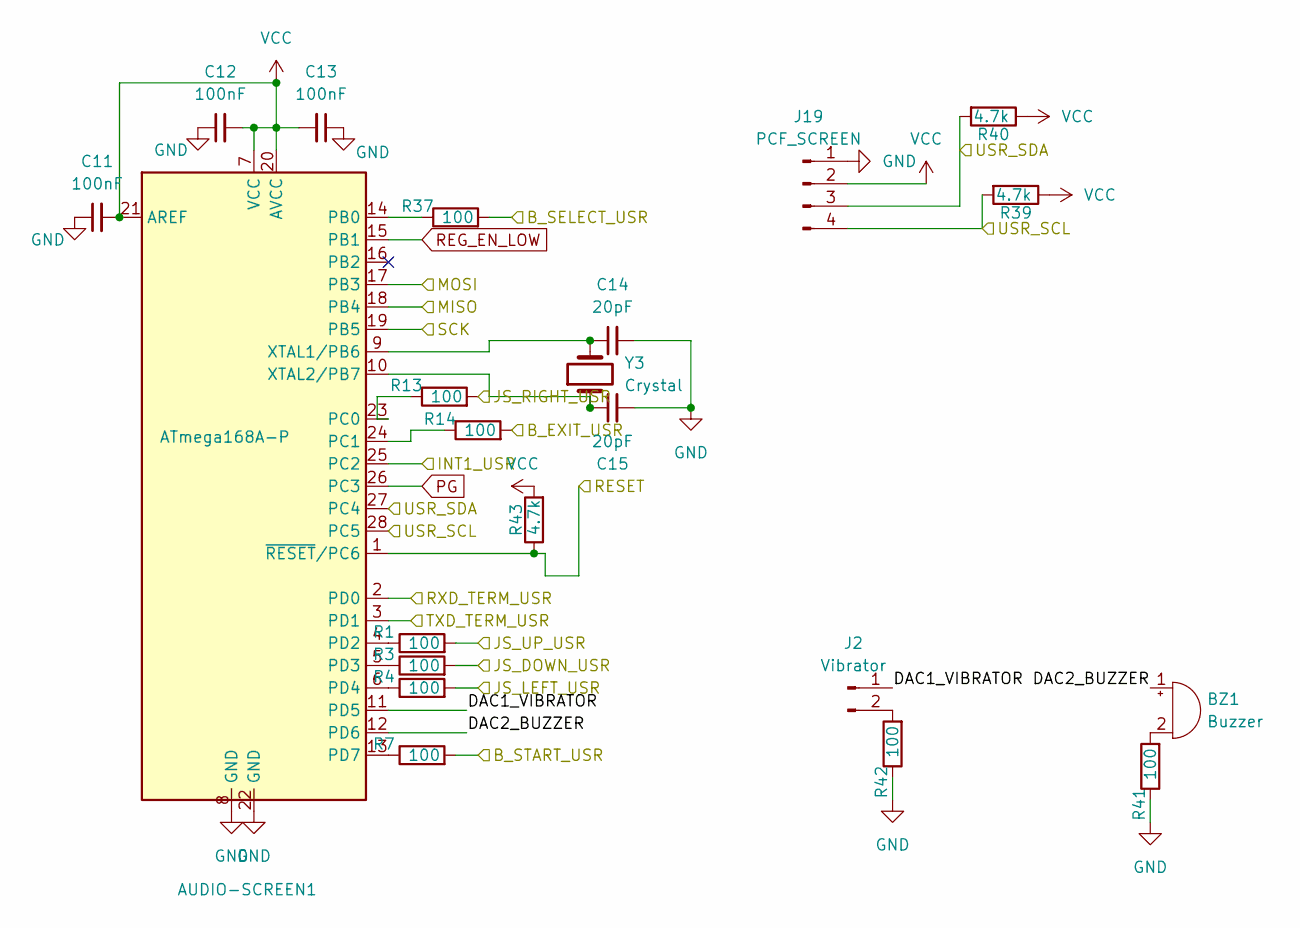
[picture p7: schematic AUDIO-SCREEN_COTROLLER.kicad_sch]

Parts:
AUDIO-SCREEN1: ATmega168A-P; DIP-28_W7.62mm
BZ1: Buzzer; Buzzer_12x9.5RM7.6
C11, C12, C13: 100nF; C_Disc_D7.5mm_W5.0mm_P5.00mm
C14, C15: 20pF; CP_Radial_D5.0mm_P2.50mm
J2: Vibrator; TerminalBlock_MaiXu_MX126-5.0-02P_1x02_P5.00mm
J19: PCF_SCREEN; TerminalBlock_MaiXu_MX126-5.0-04P_1x04_P5.00mm
R1, R3, R4, R7, R13, R14, R37, R41, R42: 100; R_Axial_DIN0207_L6.3mm_D2.5mm_P10.16mm_Horizontal
R39, R40, R43: 4.7k; R_Axial_DIN0207_L6.3mm_D2.5mm_P10.16mm_Horizontal
Y3: Crystal; Resonator-2Pin_W6.0mm_H3.0mm

Connections:
/AUDIO-SCREEN_CONTROLLER/B_EXIT_USR: R14.2; also elsewhere on the board
/AUDIO-SCREEN_CONTROLLER/B_SELECT_USR: R37.2; also elsewhere on the board
/AUDIO-SCREEN_CONTROLLER/B_START_USR: R7.2; also elsewhere on the board
/AUDIO-SCREEN_CONTROLLER/DAC1_VIBRATOR: AUDIO-SCREEN1.11 (PD5), J2.1
/AUDIO-SCREEN_CONTROLLER/DAC2_BUZZER: AUDIO-SCREEN1.12 (PD6), BZ1.1 (+)
/AUDIO-SCREEN_CONTROLLER/INT1_USR: AUDIO-SCREEN1.25 (PC2); also elsewhere on the board
/AUDIO-SCREEN_CONTROLLER/JS_DOWN_USR: R3.2; also elsewhere on the board
/AUDIO-SCREEN_CONTROLLER/JS_LEFT_USR: R4.2; also elsewhere on the board
/AUDIO-SCREEN_CONTROLLER/JS_RIGHT_USR: R13.2; also elsewhere on the board
/AUDIO-SCREEN_CONTROLLER/JS_UP_USR: R1.2; also elsewhere on the board
/AUDIO-SCREEN_CONTROLLER/MISO: AUDIO-SCREEN1.18 (PB4); also elsewhere on the board
/AUDIO-SCREEN_CONTROLLER/MOSI: AUDIO-SCREEN1.17 (PB3); also elsewhere on the board
/AUDIO-SCREEN_CONTROLLER/RESET: AUDIO-SCREEN1.1 (~RESET/PC6), R43.1; also elsewhere on the board
/AUDIO-SCREEN_CONTROLLER/RXD_TERM_USR: AUDIO-SCREEN1.2 (PD0); also elsewhere on the board
/AUDIO-SCREEN_CONTROLLER/SCK: AUDIO-SCREEN1.19 (PB5); also elsewhere on the board
/AUDIO-SCREEN_CONTROLLER/TXD_TERM_USR: AUDIO-SCREEN1.3 (PD1); also elsewhere on the board
/AUDIO-SCREEN_CONTROLLER/USR_SCL: AUDIO-SCREEN1.28 (PC5), J19.4, R39.2; also elsewhere on the board
/AUDIO-SCREEN_CONTROLLER/USR_SDA: AUDIO-SCREEN1.27 (PC4), J19.3, R40.2; also elsewhere on the board
GND: AUDIO-SCREEN1.8 (GND), AUDIO-SCREEN1.22 (GND), C11.1, C12.1, C13.1, C14.2, C15.2, J19.1, R41.1, R42.1; also elsewhere on the board
unnamed: AUDIO-SCREEN1.14 (PB0), R37.1
unnamed: AUDIO-SCREEN1.23 (PC0), R13.1
unnamed: AUDIO-SCREEN1.24 (PC1), R14.1
unnamed: AUDIO-SCREEN1.4 (PD2), R1.1
unnamed: AUDIO-SCREEN1.5 (PD3), R3.1
unnamed: AUDIO-SCREEN1.6 (PD4), R4.1
unnamed: AUDIO-SCREEN1.13 (PD7), R7.1
unnamed: AUDIO-SCREEN1.9 (XTAL1/PB6), C14.1, Y3.2
unnamed: AUDIO-SCREEN1.10 (XTAL2/PB7), C15.1, Y3.1
unnamed: BZ1.2 (-), R41.2
unnamed: J2.2, R42.2
PG: AUDIO-SCREEN1.26 (PC3); also elsewhere on the board
REG_EN_LOW: AUDIO-SCREEN1.15 (PB1); also elsewhere on the board
VCC: AUDIO-SCREEN1.7 (VCC), AUDIO-SCREEN1.20 (AVCC), AUDIO-SCREEN1.21 (AREF), C11.2, C12.2, C13.2, J19.2, R39.1, R40.1, R43.2; also elsewhere on the board

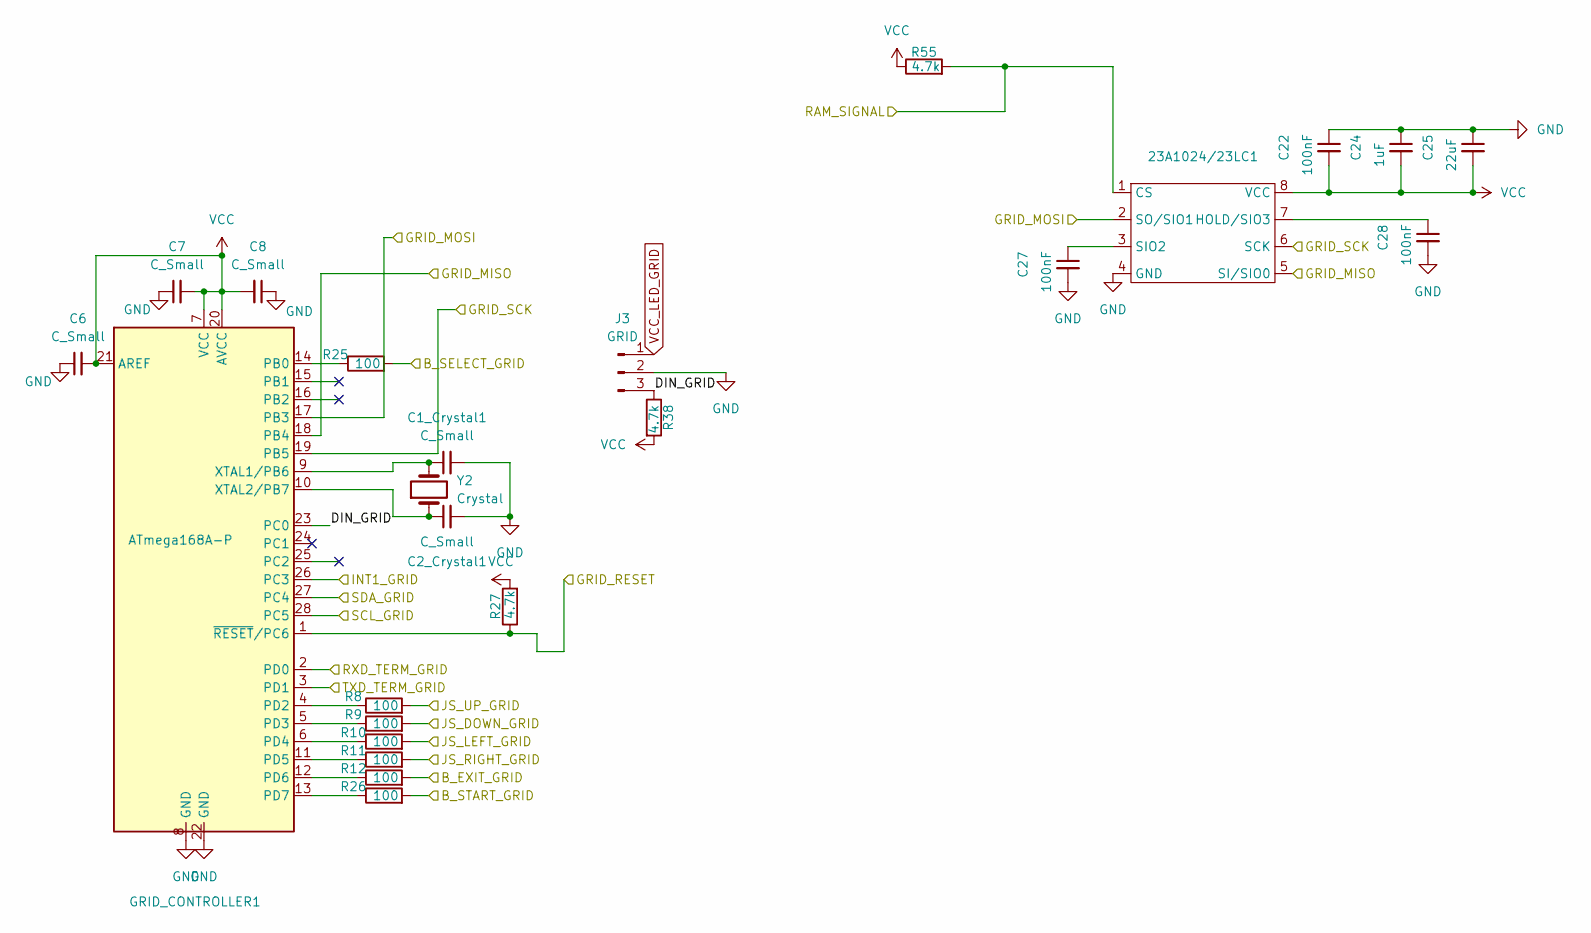
[picture p8: schematic GRID_CONTROLLER_sch.kicad_sch]

Parts:
23A1024/23LC1: CERDIP-8_W7.62mm_SideBrazed_Socket
C1_Crystal1, C2_Crystal1: C_Small; CP_Radial_D5.0mm_P2.50mm
C6, C7, C8: C_Small; C_Disc_D7.5mm_W5.0mm_P5.00mm
C22, C27, C28: 100nF; C_Disc_D7.5mm_W5.0mm_P5.00mm
C24: 1uF; C_Disc_D7.5mm_W5.0mm_P5.00mm
C25: 22uF; C_Disc_D7.5mm_W5.0mm_P5.00mm
GRID_CONTROLLER1: ATmega168A-P; DIP-28_W7.62mm
J3: GRID; TerminalBlock_MaiXu_MX126-5.0-03P_1x03_P5.00mm
R8, R9, R10, R11, R12, R25, R26: 100; R_Axial_DIN0207_L6.3mm_D2.5mm_P10.16mm_Horizontal
R27, R38, R55: 4.7k; R_Axial_DIN0207_L6.3mm_D2.5mm_P10.16mm_Horizontal
Y2: Crystal; Resonator-2Pin_W6.0mm_H3.0mm

Connections:
/AUDIO-SCREEN_CONTROLLER/B_EXIT_USR: R12.2; also elsewhere on the board
/AUDIO-SCREEN_CONTROLLER/B_SELECT_USR: R25.2; also elsewhere on the board
/AUDIO-SCREEN_CONTROLLER/B_START_USR: R26.2; also elsewhere on the board
/AUDIO-SCREEN_CONTROLLER/INT1_USR: GRID_CONTROLLER1.26 (PC3); also elsewhere on the board
/AUDIO-SCREEN_CONTROLLER/JS_DOWN_USR: R9.2; also elsewhere on the board
/AUDIO-SCREEN_CONTROLLER/JS_LEFT_USR: R10.2; also elsewhere on the board
/AUDIO-SCREEN_CONTROLLER/JS_RIGHT_USR: R11.2; also elsewhere on the board
/AUDIO-SCREEN_CONTROLLER/JS_UP_USR: R8.2; also elsewhere on the board
/AUDIO-SCREEN_CONTROLLER/RXD_TERM_USR: GRID_CONTROLLER1.2 (PD0); also elsewhere on the board
/AUDIO-SCREEN_CONTROLLER/TXD_TERM_USR: GRID_CONTROLLER1.3 (PD1); also elsewhere on the board
/AUDIO-SCREEN_CONTROLLER/USR_SCL: GRID_CONTROLLER1.28 (PC5); also elsewhere on the board
/AUDIO-SCREEN_CONTROLLER/USR_SDA: GRID_CONTROLLER1.27 (PC4); also elsewhere on the board
/CONTROLLERS/GRID_RAM_SIGNAL: 23A1024/23LC1.1 (CS), R55.2; also elsewhere on the board
/CONTROLLERS/MISO_GRID: 23A1024/23LC1.5 (SI/SIO0), GRID_CONTROLLER1.18 (PB4); also elsewhere on the board
/CONTROLLERS/MOSI_GRID: 23A1024/23LC1.2 (SO/SIO1), GRID_CONTROLLER1.17 (PB3); also elsewhere on the board
/CONTROLLERS/RESET_GRID: GRID_CONTROLLER1.1 (~RESET/PC6), R27.1; also elsewhere on the board
/CONTROLLERS/SCK_GRID: 23A1024/23LC1.6 (SCK), GRID_CONTROLLER1.19 (PB5); also elsewhere on the board
/GRID_CONTROLLER/DIN_GRID: GRID_CONTROLLER1.23 (PC0), J3.3, R38.1
GND: 23A1024/23LC1.4 (GND), C1_Crystal1.2, C2_Crystal1.2, C6.1, C7.1, C8.1, C22.1, C24.1, C25.1, C27.2, C28.2, GRID_CONTROLLER1.8 (GND), GRID_CONTROLLER1.22 (GND), J3.2; also elsewhere on the board
unnamed: 23A1024/23LC1.7 (HOLD/SIO3), C28.1
unnamed: 23A1024/23LC1.3 (SIO2), C27.1
unnamed: GRID_CONTROLLER1.14 (PB0), R25.1
unnamed: GRID_CONTROLLER1.4 (PD2), R8.1
unnamed: GRID_CONTROLLER1.5 (PD3), R9.1
unnamed: GRID_CONTROLLER1.6 (PD4), R10.1
unnamed: GRID_CONTROLLER1.11 (PD5), R11.1
unnamed: GRID_CONTROLLER1.12 (PD6), R12.1
unnamed: GRID_CONTROLLER1.13 (PD7), R26.1
unnamed: C1_Crystal1.1, GRID_CONTROLLER1.9 (XTAL1/PB6), Y2.2
unnamed: C2_Crystal1.1, GRID_CONTROLLER1.10 (XTAL2/PB7), Y2.1
VCC: 23A1024/23LC1.8 (VCC), C6.2, C7.2, C8.2, C22.2, C24.2, C25.2, GRID_CONTROLLER1.7 (VCC), GRID_CONTROLLER1.20 (AVCC), GRID_CONTROLLER1.21 (AREF), R27.2, R38.2, R55.1; also elsewhere on the board
VCC_LED_GRID: J3.1; also elsewhere on the board

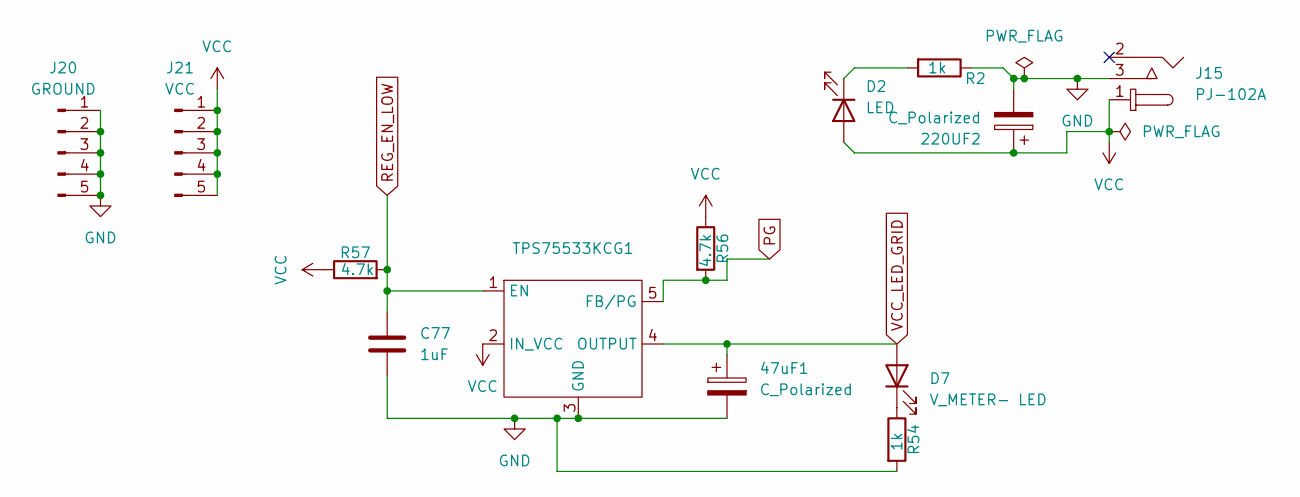
[picture p9: schematic untitled.kicad_sch]

Parts:
47uF1, 220UF2: C_Polarized; C_Disc_D3.0mm_W1.6mm_P2.50mm
C77: 1uF; C_Disc_D7.5mm_W5.0mm_P5.00mm
D2: LED; LED_D1.8mm_W3.3mm_H2.4mm
D7: V_METER- LED; LED_D1.8mm_W3.3mm_H2.4mm
J15: PJ-102A; BarrelJack_Horizontal; MPN PJ-102A; Digi-Key_PN CP-102A-ND
J20: GROUND; TerminalBlock_MaiXu_MX126-5.0-04P_1x04_P5.00mm
J21: VCC; TerminalBlock_MaiXu_MX126-5.0-04P_1x04_P5.00mm
R2, R54: 1k; R_Axial_DIN0207_L6.3mm_D2.5mm_P10.16mm_Horizontal
R56, R57: 4.7k; R_Axial_DIN0207_L6.3mm_D2.5mm_P10.16mm_Horizontal
TPS75533KCG1: TO-220-5_Vertical

Connections:
GND: 47uF1.2, 220UF2.2, C77.2, J15.3, J20.1, J20.2, J20.3, J20.4, J20.5, R2.1, R54.2, TPS75533KCG1.3 (GND); also elsewhere on the board
unnamed: D2.1 (K), R2.2
unnamed: D7.1 (K), R54.1
PG: R56.2, TPS75533KCG1.5 (FB/PG); also elsewhere on the board
REG_EN_LOW: C77.1, R57.2, TPS75533KCG1.1 (EN); also elsewhere on the board
VCC: 220UF2.1, D2.2 (A), J15.1, J21.1, J21.2, J21.3, J21.4, J21.5, R56.1, R57.1, TPS75533KCG1.2 (IN_VCC); also elsewhere on the board
VCC_LED_GRID: 47uF1.1, D7.2 (A), TPS75533KCG1.4 (OUTPUT); also elsewhere on the board

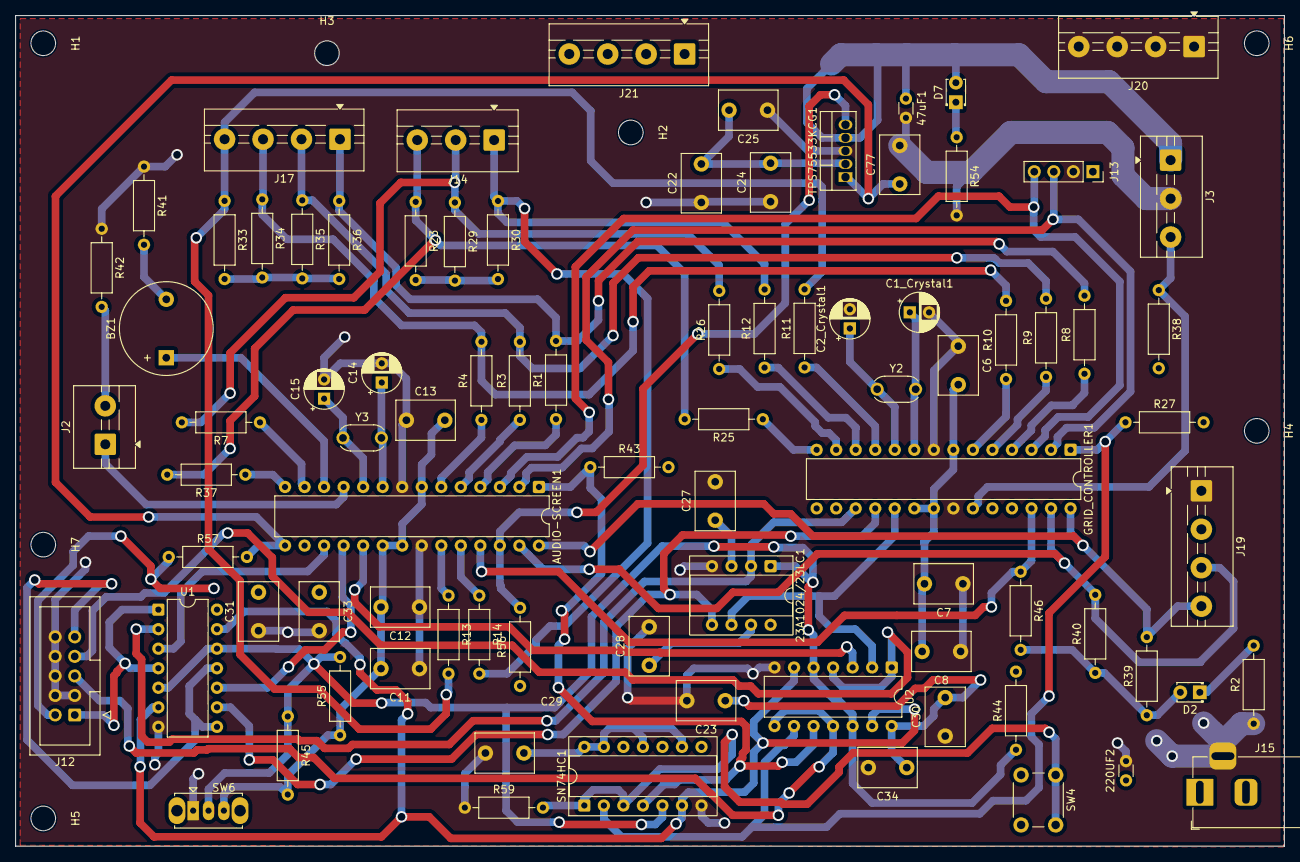
[picture p10: board SNAKE_GAME.kicad_pcb from above]

Board: 2 copper layers, 165.0 x 108.0 mm, 92 parts (0 on the bottom side), 59 nets.

Other parts of the board:
C23: 100nF; C_Disc_D7.5mm_W5.0mm_P5.00mm
R44: 4.7k; R_Axial_DIN0207_L6.3mm_D2.5mm_P10.16mm_Horizontal

Their connections:
/CONTROLLERS/GRID_RAM_SIGNAL: R44.1; also elsewhere on the board
GND: C23.2; also elsewhere on the board
VCC: C23.1, R44.2; also elsewhere on the board
