Lucasmnascimento94/CS-341/ATMEGA-SCHEMATICS/ATMEGA-SCHEMATICS.kicad_pcb

## KiCad design ATMEGA-SCHEMATICS/ATMEGA-SCHEMATICS.kicad_pcb (2025-09-08)

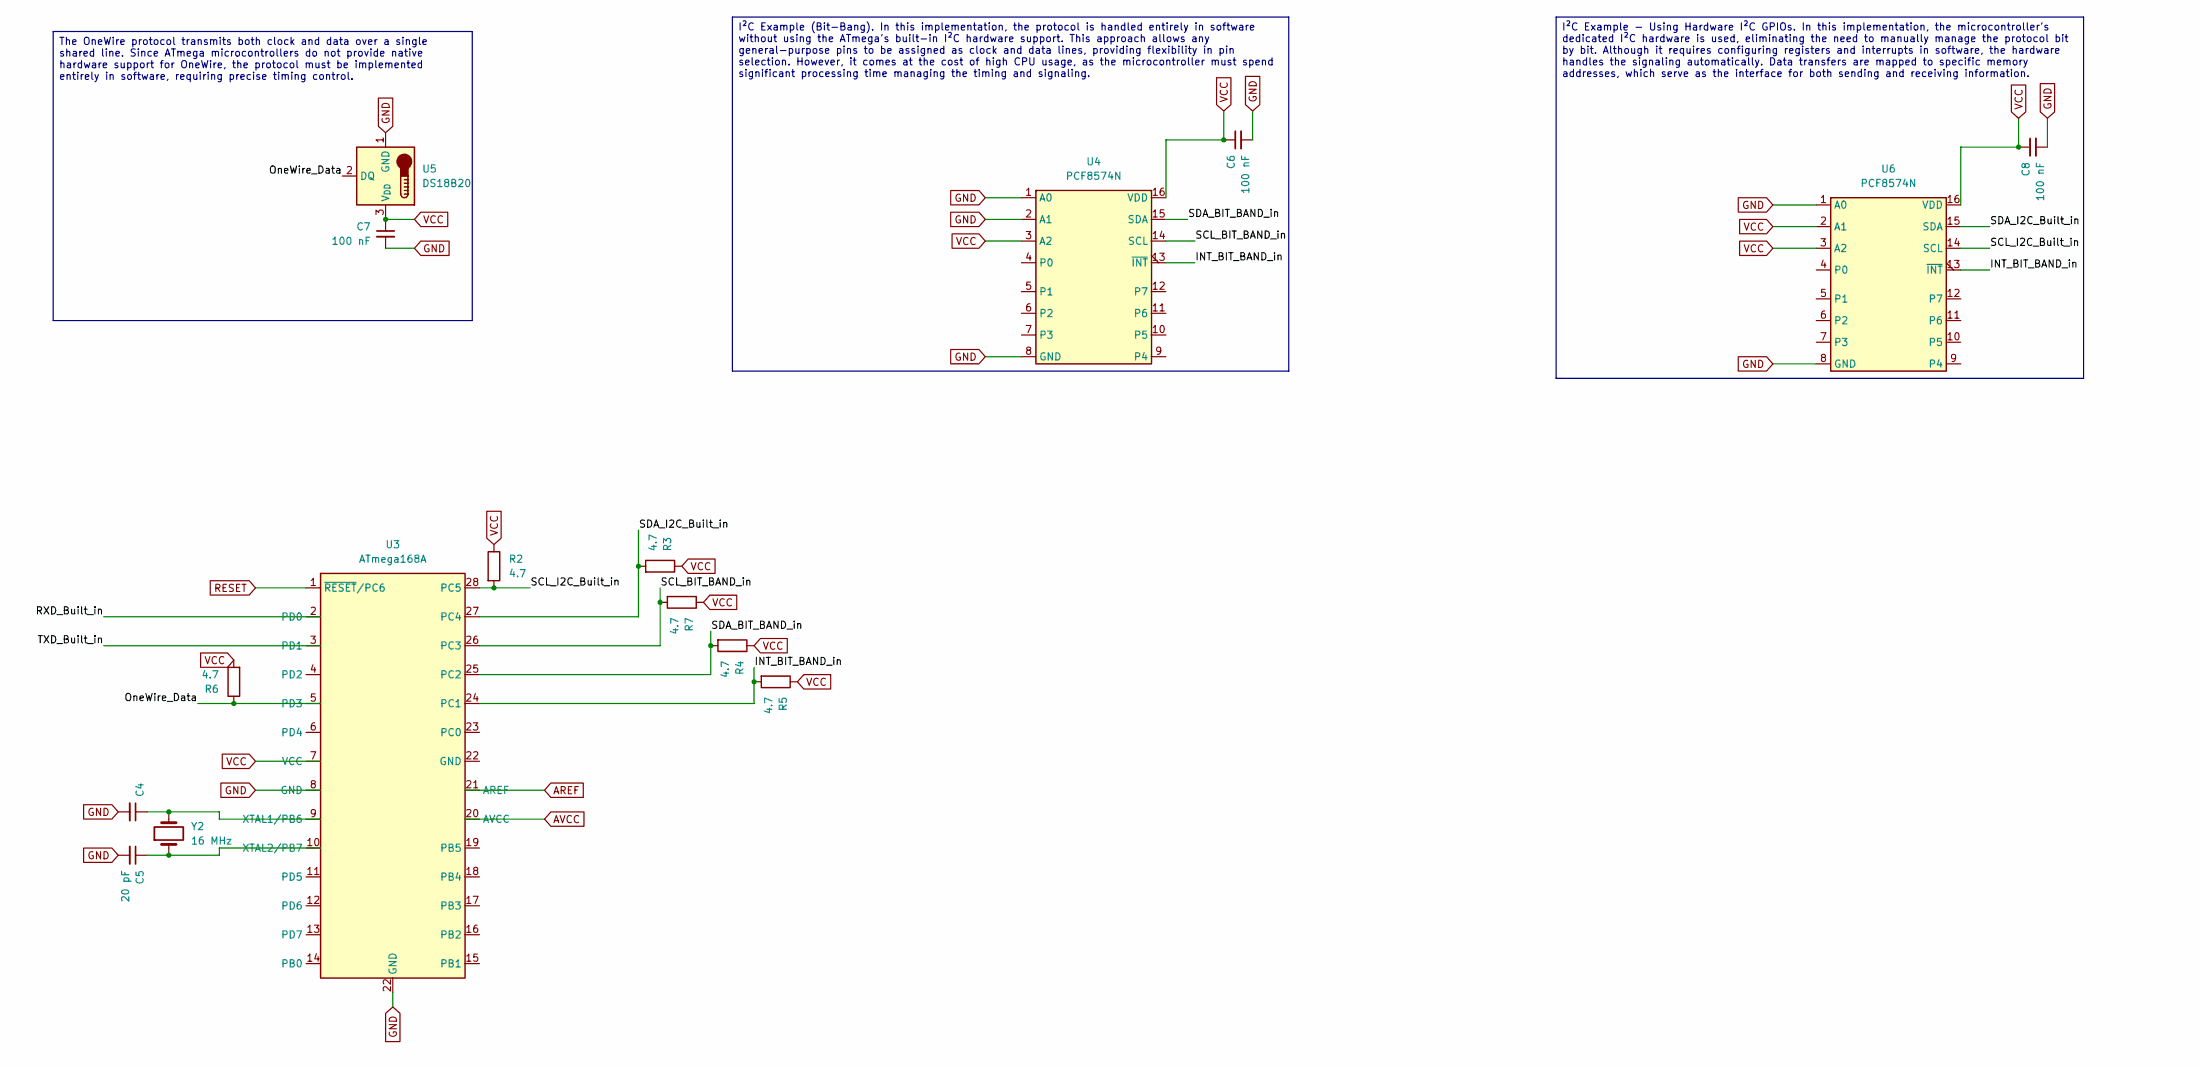
[picture p16: schematic SCHEMATIC.kicad_sch]

Parts:
C4, C5: 20 pF; CP_Radial_D5.0mm_P2.50mm
C6, C7, C8: 100 nF; CP_Radial_D5.0mm_P2.50mm
R2, R3, R4, R5, R6, R7: 4.7; R_Axial_DIN0207_L6.3mm_D2.5mm_P10.16mm_Horizontal
U3: ATmega168A; DIP-28_W7.62mm
U4, U6: PCF8574N; CERDIP-16_W7.62mm_SideBrazed_Socket
U5: DS18B20; TO-92_Inline
Y2: 16 MHz; Resonator-2Pin_W6.0mm_H3.0mm

Connections:
/SCHEMATIC_EXAMPLE/INT_BIT_BAND_in: R5.2, U3.24 (PC1), U4.13 (~INT), U6.13 (~INT)
/SCHEMATIC_EXAMPLE/OneWire_Data: R6.1, U3.5 (PD3), U5.2 (DQ)
/SCHEMATIC_EXAMPLE/RXD_Built_in: U3.2 (PD0)
/SCHEMATIC_EXAMPLE/SCL_BIT_BAND_in: R7.2, U3.26 (PC3), U4.14 (SCL)
/SCHEMATIC_EXAMPLE/SCL_I2C_Built_in: R2.2, U3.28 (PC5), U6.14 (SCL)
/SCHEMATIC_EXAMPLE/SDA_BIT_BAND_in: R4.2, U3.25 (PC2), U4.15 (SDA)
/SCHEMATIC_EXAMPLE/SDA_I2C_Built_in: R3.2, U3.27 (PC4), U6.15 (SDA)
/SCHEMATIC_EXAMPLE/TXD_Built_in: U3.3 (PD1)
AREF: U3.21 (AREF)
AVCC: U3.20 (AVCC)
GND: C4.2, C5.2, C6.2, C7.2, C8.2, U3.8 (GND), U3.22 (GND), U4.1 (A0), U4.2 (A1), U4.8 (GND), U5.1 (GND), U6.1 (A0), U6.8 (GND)
unnamed: C4.1, U3.9 (XTAL1/PB6), Y2.2
unnamed: C5.1, U3.10 (XTAL2/PB7), Y2.1
RESET: U3.1 (~RESET/PC6)
VCC: C6.1, C7.1, C8.1, R2.1, R3.1, R4.1, R5.1, R6.2, R7.1, U3.7 (VCC), U4.3 (A2), U4.16 (VDD), U5.3 (V_{DD}), U6.2 (A1), U6.3 (A2), U6.16 (VDD)

Notes on the sheet:
I²C Example - Using Hardware I²C GPIOs. In this implementation, the microcontroller's dedicated I²C hardware is used, eliminating the need to manually manage the protocol bit by bit. Although it requires configuring registers and interrupts in software, the hardware handles the signaling automatica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
The OneWire protocol transmits both clock and data over a single shared line. Since ATmega microcontrollers do not provide native hardware support for OneWire, the protocol must be implemented entirely in software, requiring precise timing control.
I²C Example (Bit-Bang). In this implementation, the protocol is handled entirely in software without using the ATmega's built-in I²C hardware support. This approach allows any general-purpose pins to be assigned as clock and data lines, providing flexibility in pin selection. However, it comes at t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

Board: 2 copper layers, 16 parts (0 on the bottom side), 10 nets, no tracks yet.
