Lucasmnascimento94/CS-341/ATMEGA-SCHEMATICS/SNAKE_GAME/program/gridController/StartSetUp/includes.h

#ifndef INCLUDES_H
#define INCLUDES_H
#include <avr/io.h>
#include <avr/interrupt.h>
#include <stdint.h>
#include <util/delay.h>
#include <stdlib.h>
#include <stdbool.h>
#include <avr/interrupt.h>


#endif
