Lucasmnascimento94/CS-341/ATMEGA-SCHEMATICS/SNAKE_GAME/program/gridController/StartSetUp/isr.h

/**
 * @file    isr.h
 * @brief   <one-line summary of the module>
 * @details <optional longer description; usage, constraints, timing notes>
 *
 * @author  Lucas Nascimento <lucas@hausintelligence.com>
 * @version 1.0.0
 * @date    2025-09-11
 *
 * @target  ATmega168 @ 16 MHz (F_CPU=16000000UL)
 * @deps    avr-libc
 *
 * @copyright
 * Copyright (c) 2025 Lucas Nascimento
 *
 * @changelog
 * - 1.2.0 (2025-09-11): Switched WS2812 timing to SBI/CBI, added PCINT joystick.
 * - 1.1.0 (2025-09-05): Added cycle-accurate delays.
 * - 1.0.0 (2025-08-30): Initial release.
 */
#ifndef ISR_H
#define ISR_H

#include "start.h"
#include "DataStructures.h"

#endif
