Lucasmnascimento94/CS-341/ATMEGA-SCHEMATICS/SNAKE_GAME/isp_tests/isp/src/isp.c

#include "isp.h"
#include "clock.h"
#include <avr/iom168.h>
#include <avr/sfr_defs.h>
#include <stdint.h>
#include <util/delay.h>

void ispInit() {
  // enable SCK, MOSI, CS as output
  DDRB = _BV(SCK) | _BV(MISO) | _BV(MOSI) | _BV(CS);

  // set MISO high until slave sets as output
  PORTB |= _BV(MISO);

  // set SS high so master doesn't get overwritten
  PORTB |= _BV(PB2);

  // set CS high (idle)
  PORTB |= _BV(CS);

  // enable SPE, re-enable master, set pre-scaler to 64
  SPCR = _BV(SPE) | _BV(MSTR) | _BV(SPR1) | _BV(SPR0);
}

// following powerup protocl described in 28.8.2, p304
void ispPowerUp() {
  // set SCK low
  PORTB &= ~_BV(SCK);

  // pulse RESET high two clock cycles
  // NOTE: this is wrong
  START_ISP;
  _delay_us(2 * CLK_CYC_US);
  STOP_ISP;

  // wait 20ms before enabling serial programming
  _delay_ms(20);
}

uint8_t ispTransmitByte(uint8_t data) {
  SPDR = data;
  while (!(SPSR & (1 << SPIF)))
    ;
  return SPDR;
}

uint8_t ispProgrammingEnable() {
  ispTransmitByte(0xAC);
  ispTransmitByte(0x53);
  ispTransmitByte(0x00);
  ispTransmitByte(0x00);
  return 0;
}

void ispChipErase() {
  ispTransmitByte(0xAC);
  ispTransmitByte(0x80);
  ispTransmitByte(0x00);
  ispTransmitByte(0x00);
}

void ispLoadProgramMemoryPageHighByte(uint16_t adr, uint8_t data) {
  ispTransmitByte(0x48);
  ispTransmitByte(0x00);
  ispTransmitByte(adr & 0xFF);
  ispTransmitByte(data);
}

void ispLoadProgramMemoryPageLowByte(uint16_t adr, uint8_t data) {
  ispTransmitByte(0x40);
  ispTransmitByte(0x00);
  ispTransmitByte(adr & 0xFF);
  ispTransmitByte(data);
}

void ispReadProgramMemoryHighByte(uint16_t adr) {
  ispTransmitByte(0x28);
  ispTransmitByte(adr >> 8);
  ispTransmitByte(adr & 0xFF);
  ispTransmitByte(0x00);
}

void ispReadProgramMemoryLowByte(uint16_t adr) {
  ispTransmitByte(0x20);
  ispTransmitByte(adr >> 8);
  ispTransmitByte(adr & 0xFF);
  ispTransmitByte(0x00);
}

void ispReadSignatureByte(uint8_t adr) {
  ispTransmitByte(0x30);
  ispTransmitByte(0x00);
  ispTransmitByte(adr);
  ispTransmitByte(0x00);
}

void ispReadFuseBits() {
  ispTransmitByte(0x50);
  ispTransmitByte(0x00);
  ispTransmitByte(0x00);
  ispTransmitByte(0x00);
}

void ispWriteProgramMemoryPage(uint16_t adr) {
  ispTransmitByte(0x4C);
  ispTransmitByte(adr >> 8);
  ispTransmitByte(adr & 0xFF);
  ispTransmitByte(0x00);
}
