Lucasmnascimento94/CS-341/(commit log)

2025-10-10 isp_tests initial commit
    [read_fuse.csv]
2025-10-10 removed spi .c .h
2025-10-10 updated comments + removed spi.h include
2025-10-13 testing writing blinky to target
    [blinky.csv, write_blinky.csv]
2025-10-13 ispInit before ispPowerUp
    [write_blinky.csv]
2025-10-13 it works :)
    [write_blinky.csv]
2025-10-15 fixed CS toggling; timing delays follow avrdude/usbasp
    [isp.c, main.c]
2025-10-17 cleaned up code + power test csvs for lucas
    [powertest_5vsupply.csv, powertest_breadboard.csv]
2025-10-24 swapped args in ispLoadMemoryPage____Byte
    [isp.c, isp.h, main.c]
2025-11-19 stm32-screen-test init
